rafaelromao/prisma/README.md

# Prisma

A wireless Choc v1 split keyboard: the handwired Diamond's 1333+2 layout on one
reversible PCB per half, a XIAO-sized nRF52840 module, and a 7 × 20 × 40 mm (500 mAh)
battery in each half. The halves join magnetically into a unibody, or stack back to
back for transport. The [project page](https://rafaelromao.github.io/prisma/) has the
boards, renders, BOM and build guide on one page.

## One board, either module

The board takes a Seeed XIAO nRF52840 (the genuine one) or a NologoTech Super52840
(also sold as "MINI NRF52840", "NRF52840 RE:1.4"). Both have the same 14 edge pins
on the same nRF52840 pins, so the firmware is the same; they differ underneath,
where the board reaches the battery, the 12th key and reset:

- **Battery.** Their battery pads are in the same two spots, but swapped: the XIAO's
  + (VBAT) is the pad nearer the module's middle, the Super52840's + (B+) the one
  nearer the USB end. A **battery selector** on the switch face picks which hole is
  +: bridge the row labelled `+MID` for a XIAO, `+USB` for a Super52840. Never both:
  that shorts the battery.
- **12th key (P0.09).** The XIAO's NFC1 pad, or the Super52840's P0.09 pad in its row
  of nine extra GPIO pads: a hole under each, on the same net. Under a XIAO, the
  Super52840's hole touches its NFC2 pad (P0.10), which is unused and idle.
- **Reset** is in the same place on both.
- The Super52840's USB-C legs come through its board: the PCB has clearance holes
  under them, and its USB-C sticks out 0.8 mm further, which the case's recess takes.

The Super52840's pads were measured from several photos, beside a ruler, against the
2.54 mm pin pitch. Its USB-C sits 0.3 to 0.6 mm off centre, towards the D0–D6 pins, so
the leg clearance holes, the notch in the board edge and the case's recess all allow
for that either way (its RST, GND and SWD pads land within 0.2 mm of the XIAO's). The
battery holes are small and sit inside both modules' pads, at least 0.25 mm from the
Super52840's GPIO row under the other half's module, wherever between the two photos'
readings that row really is.

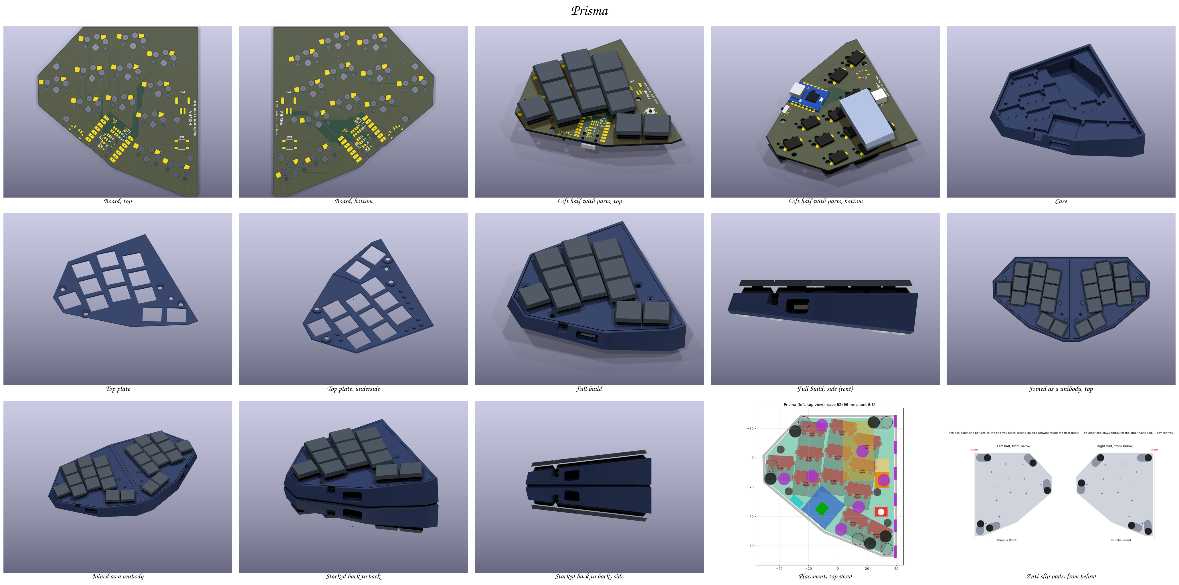
[picture p1: renders/all.png]
All views


| | |
|---|---|
| Keys | 24 (12 per half): 3×3, one pinky key, two thumbs, all 1u Choc |
| Key layout | The Diamond's angles and stagger (from `body_right.stl`), packed at Choc spacing (18 × 17 mm) |
| PCB | 87.6 × 92.3 mm, 2 layers, 1.6 mm, reversible: one design, order 5. Same cut-diamond outline, so two boards side by side form the diamond. A notch in the edge in front of the USB-C lets a cable's overmold reach the port |
| Wiring | Diodeless, one pin per key (11 Xiao pins + NFC1) |
| Case | Solid base, a pocket per part (0.6 mm clearance), 0.5 mm around the PCB and plate (0.3 at the seam), 93 × 100.5 mm per half at the girdle (the rim is 91.6 × 96.5), with a 45° chamfer under it; tent 6.6°; 20.4 mm at the seam, 10.5 mm at the outer edge (plate included, keycaps excluded). Five pad slots under the floor (below) |
| Anti-slip pads | 5 × 8×2 mm silicone bump-ons per half, as on the original Diamond's base: each slot under the floor (8.6 mm wide, 1.1 deep) holds two pad spots, 8.7 mm apart. Each half sticks its pad in a different end, so stacked, each pad drops into the other half's empty end and the floors (and magnets) still meet. Every key centre sits at least 2.8 mm inside each half's pads, so a press on a border key can't tip it |
| Top plate | Covers the whole board: 1.2 mm Choc v1 plate, 1.0 mm over the PCB (the flange sits 2.2 mm up), 14.0 mm cutouts (`cut_tol` 0.1 per side), a 0.5 mm pocket over the Xiao area for solder blobs, a pocket and cone over the reset button, support pillars, countersunk screw bosses, chamfered bottom edge |
| Power | XIAO nRF52840 or Super52840, 500 mAh 1S LiPo (nominal 7 × 20 × 40 mm) on a JST PH 2.0 socket, MSK-12C02 power switch next to the USB port on the lower outer facet. The wall has a recess the size of a USB-C overmold (14.6 × 7.4 mm, rounded corners, room for a module whose port sits off centre) in front of the port, and a slot open to the top for the lever, widening outwards for a fingernail, with a rounded floor |
| Reset | A 5.1 × 5.1 × 2.0 mm SMD tact switch (TS-1187A) on the switch face, in the nook between the index finger's bottom key and the thumbs, 7.6 mm from the nearest keycap. It reaches through a 45° cone in the plate (4.2 mm across at the top, 2.8 at the throat) with its plunger 0.2 mm under the plate's top: a fingertip presses it, keycaps and palms don't. Press once to reboot, twice for the bootloader, with the case closed |
| Screws | 4 × M3 × 8 flat head (90° countersunk) per half: through the plate and PCB, self-tapping into the solid Nylon base (2.5 mm pilot). `SCREW` in `design.py` switches to heat-set inserts |
| Magnets | One part everywhere: 8 × 1.5 mm N52 discs. Each half has 13: 4 original stacking positions, 3 stand contacts on a circle around the estimated centre of gravity, and 6 evenly spread across the inner wall at 17.8 mm pitch. Every pocket keeps 0.5 mm of plastic all round |
| Assembly | Iron only: no reflow-only parts |

The 500 mAh bay moves the battery away from the inner seam and raises the PCB **1.8 mm**,
keeping the existing 6.6° tent, PCB outline, connector and screw-hole positions. The nominal
7 × 20 × 40 mm finished pack is checked with a 7.5 × 20.5 × 41 mm envelope and the case's
clearance. Measure the actual protected pack, including tabs and wire exit, before printing;
never compress a pouch cell to make it fit. The electrical board and pin map are unchanged.
The trackball and trackpad use smaller 752025, 250 mAh batteries.

Use the half cases, dock and module parts from the same version together: their front facets and
heights are matched.

## Independent tenting on the Ugreen's tilting platform

Each half has three extra floor magnets on a **44 mm circle**, spaced **120° apart** around
the estimated assembled centre of gravity. The pattern is derived from a mass-weighted model
of the nylon case, PCB, battery, switches and magnets, checked by `stand_mount.py`; it is not
a measured balance point. Use two **steel tilting phone platforms**, not the stands' bases.
The owner has tested the platforms and confirmed that they attract magnets. The existing
case magnets attach directly: **no extra platform magnets or glue are required**.
All ten possible foot positions lie outside the centred 54 mm circular contact patch,
with at least **11.55 mm planar edge clearance**. They do not create an air gap there.
Keep the case magnets flush and adhesive off their faces. A larger or noncircular platform
must be checked against the feet, rubber coverings, lips and other obstructions separately.
The estimated gravity projection remains inside the three-contact triangle through 35° of tilt;
this does not certify the magnets' holding force or the stand's own stability.

`python3 stand_mount.py` checks the group and writes 1:1 alignment templates (not glue guides):
[left](case/stand_magnet_template_left.svg), [right](case/stand_magnet_template_right.svg).
Print at 100%: the dashed contact boundary is **54 mm** across; the magnet-centre circle is 44 mm.
That is the required clear flat
patch, **not a confirmed Ugreen measurement**. The 54 mm circle leaves only 1 mm from an
8 mm magnet's edge to the platform edge; prefer about **60 mm** where the real platform
still clears all feet. Measure its shape and surface before use. Steel attraction is confirmed,
but slip/peel resistance, typing loads and stability at the chosen tilt still need a physical
load test. Aluminium and nonmagnetic stainless steel are unsuitable; some stainless grades
are magnetic, so test the actual platform. The render uses an illustrative stand/platform.

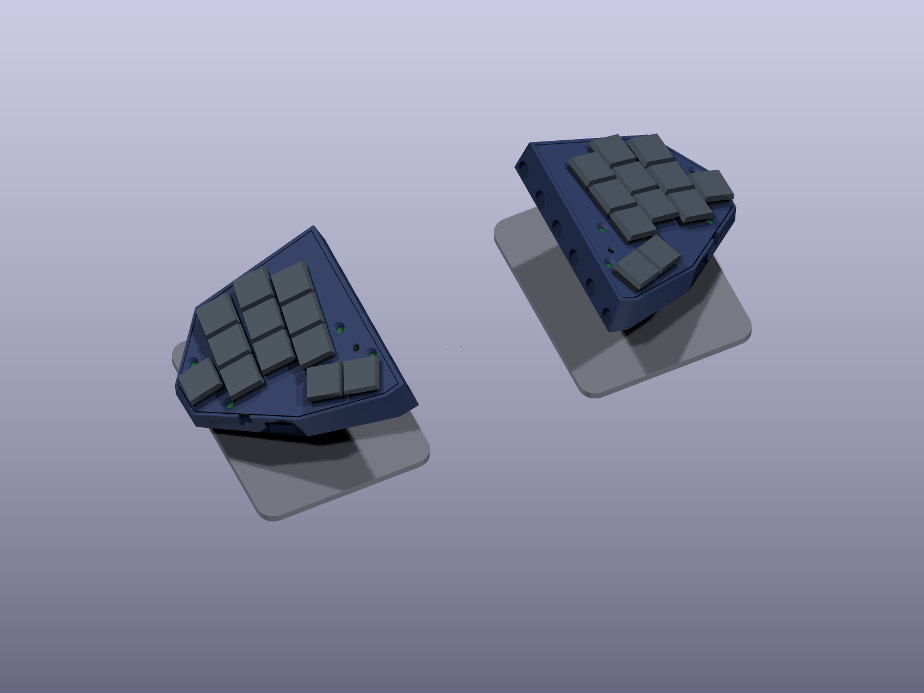
[picture p2: renders/independent_tenting.png]
Each half on its own tilting stand


## Before ordering

The board is made in one batch, so check what software can't:

1. **Print** `fab/print_1to1_F_face.pdf` and `fab/print_1to1_B_face.pdf` at 100 % ("Actual
   size", no fit to page). The board outline must measure 87.55 mm across.
2. **Lay the real parts on the prints**, each on the face it's soldered to. The module's
   castellations go over the edge pads, with its USB-C at the board edge. A Choc switch's pins and
   pegs go over one key's holes, and its hot-swap socket over the socket pads on the other face.
   Then the JST socket, the MSK-12C02 (its two pegs in the small holes) and the reset button.
3. **Super52840:** on the print, its B+ and B- pads must cover the two holes in the battery box,
   its `009` pad the round hole in the P0.09 box, and its USB-C legs land inside the two pairs of
   slots. Measure its height from its underside to the top of its USB-C shell: the case allows
   4.3 mm (the XIAO's).
4. **Firmware:** rebuild it before flashing (`b prisma -c` in rafaelromao/keyboards, branch
   `prisma`). `check_pcb.py` confirms that branch lists the board's pins, given the shield's
   `prisma_peripheral_left.overlay` and `_right.overlay` copied to `.render/fw_left.overlay`
   and `.render/fw_right.overlay`.

Checked by the scripts: JLCPCB's limits in the DRC (`pcb/prisma.kicad_dru`: annular ring
 0.18, pad holes 0.45 apart, tracks and clearance 0.10, silkscreen 1.0 mm text with a 0.15 stroke),
no tracks under the module's antenna, every net against its intent and the firmware's pin lists
(`check_pcb.py`), both modules' underside pads against the board's copper, and every part, plug,
screw, magnet and pad against the case (`check_fit.py`).

**Fabrication gate:** the battery holes have a 0.6 mm drill in a 0.96 mm pad: a **0.18 mm
annular ring**, the configured absolute minimum, not the 0.25 mm recommendation. The small
ring preserves the underside-pad and routing clearances; do not enlarge it without rerouting
and rechecking both module options. Obtain the fabricator's explicit acceptance of these
holes before ordering. A clean DRC does not establish production yield.

## Files

| Path | What |
|---|---|
| `fab/prisma_jlcpcb.zip` | Gerbers + drill files: upload to JLCPCB as they are |
| `fab/print_1to1_F_face.pdf`, `fab/print_1to1_B_face.pdf` | Both faces at full size, to lay the real parts on before ordering |
| `pcb/` | The KiCad 9 project, its footprint library, 3D stand-ins, and DRC rules |
| `case/case_left.stl`, `case/case_right.stl` | The printed base |
| `case/plate_left.stl`, `case/plate_right.stl` | The printed top plate, oriented top face down for printing |
| `case/dock.stl`, `case/insert.stl` | The cyberdeck dock, and the placeholder for its drawer (below) |
| `stls/` | The same printable parts under print-friendly names: case and plate left/right, dock, drawer insert, module tray, and the trackball/trackpad lids |
| `stand_mount.py`, `case/stand_magnet_template_*.svg` | Independent-stand contact check and 1:1 platform-magnet templates |
| `trackball/`, `trackpad/` | The drawer modules: scripts, `case/` STLs; the trackball's board in `pcb/` and `fab/` |
| `zmk/` | The modules' ZMK shields |
| `renders/` | Board, board with parts, case, full build; `all.png` has every view on one sheet |
| `BOM.md` | Parts list (AliExpress search terms) |
| `BUILD.md` | Hand-soldering and assembly guide, testing, printing |
| `index.html` | The project on one page: both boards, the renders, the BOM and the build guide (also served as the GitHub Pages home) |
| `design.png` | Top view of the placement: sockets (red), Xiao, battery, JST, magnets, screws, the reset button (red, its cone white), pad slots (grey: left pads filled, the right half's dashed) |
| `renders/pads.png` | Both floors from below: where each half's pads go |
| `*.py`, `*.sh` | The generators: everything above is built from them |

## Renders

| Board, top | Board, bottom |
|---|---|
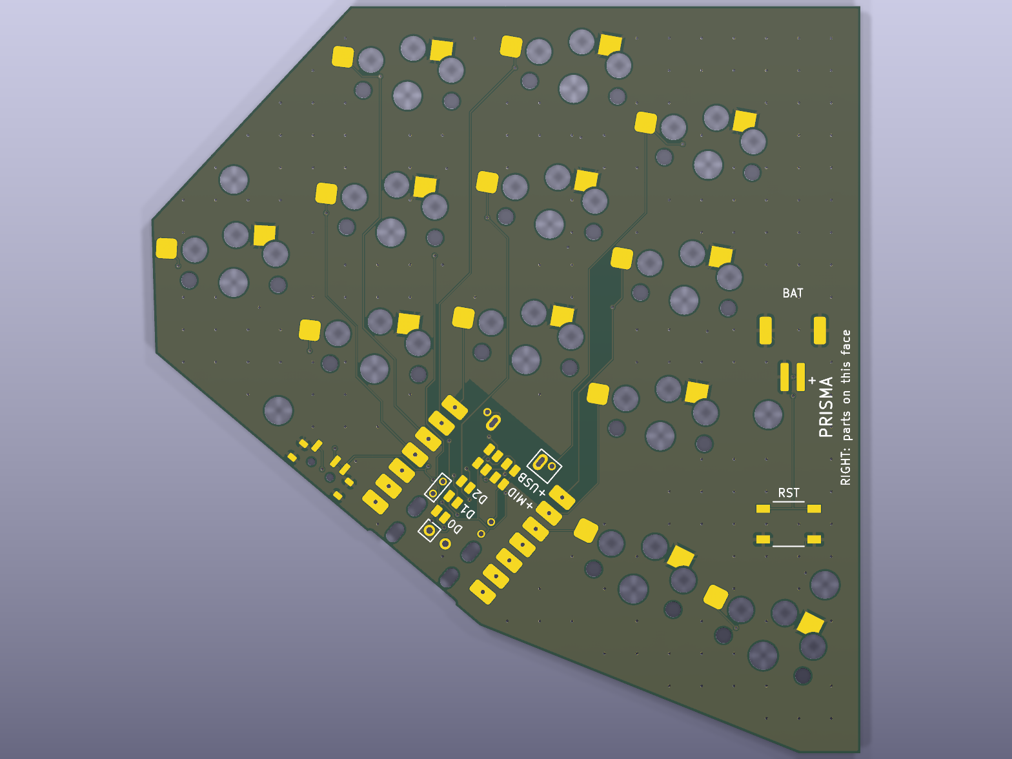
[picture p3: renders/board_top.png]
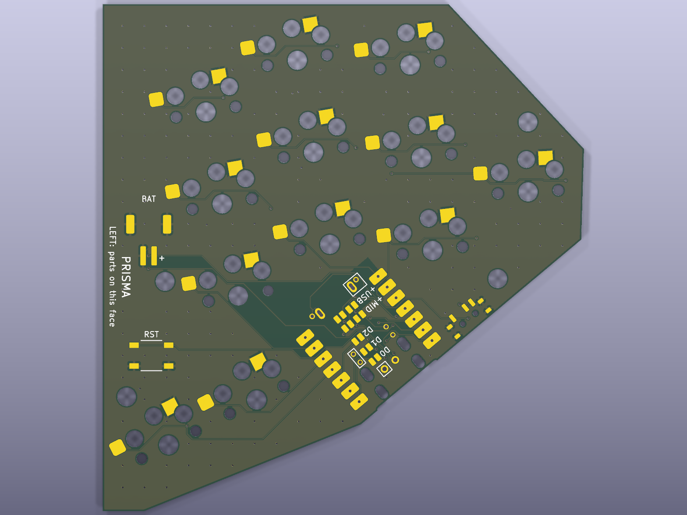
[picture p4: renders/board_bottom.png]
|  |  |
| **Left half with parts, top** | **Left half with parts, bottom** |
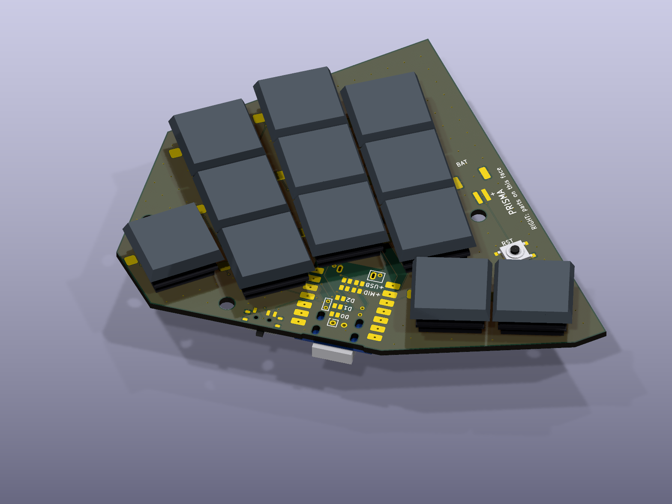
[picture p5: renders/parts_top.png]
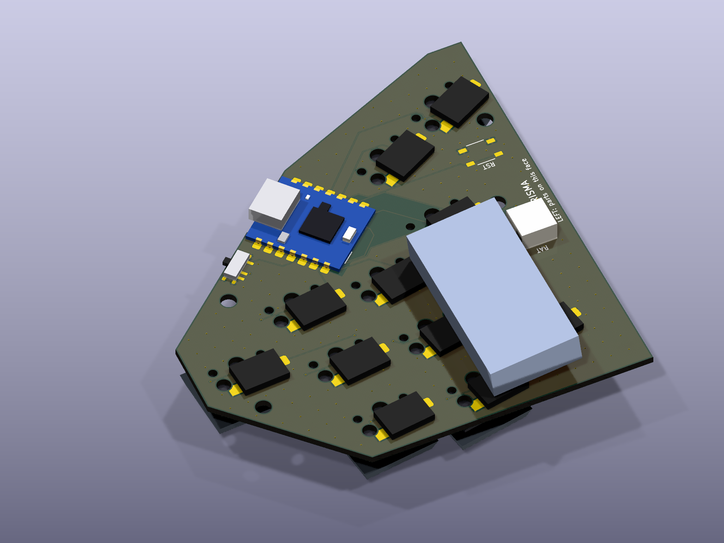
[picture p6: renders/parts_bottom.png]
|  |  |
| **Case** | **Full build, side (the tent)** |
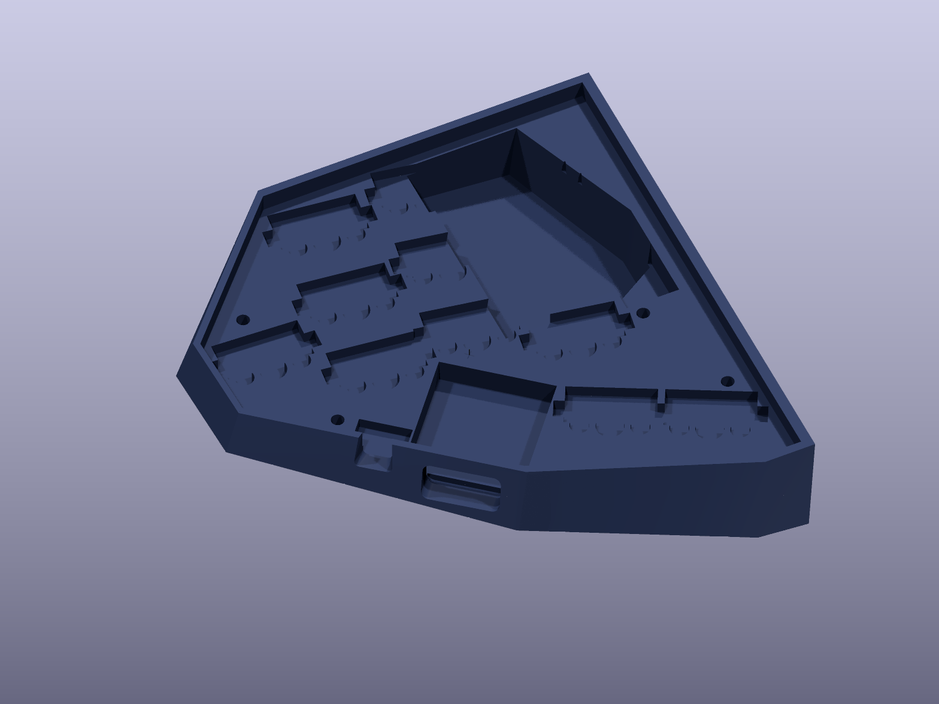
[picture p7: renders/case.png]
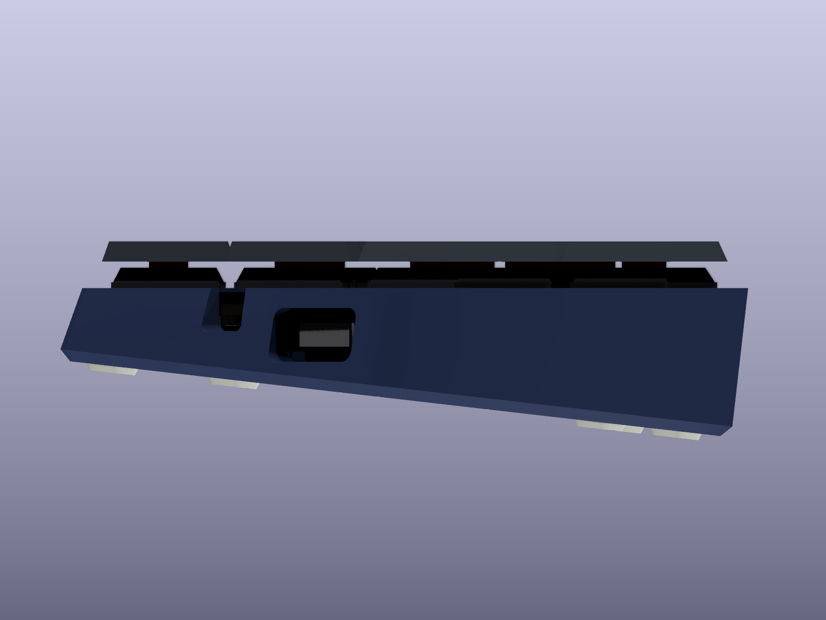
[picture p8: renders/full_side.png]
|  |  |
| **Top plate** | **Top plate, underside** |
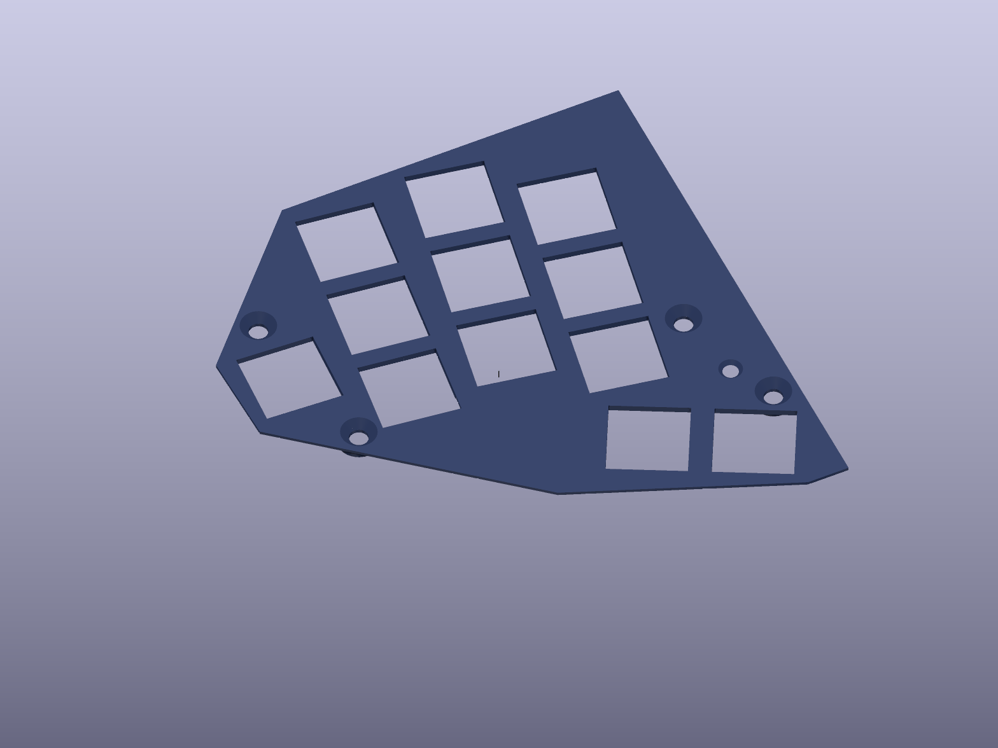
[picture p9: renders/plate.png]
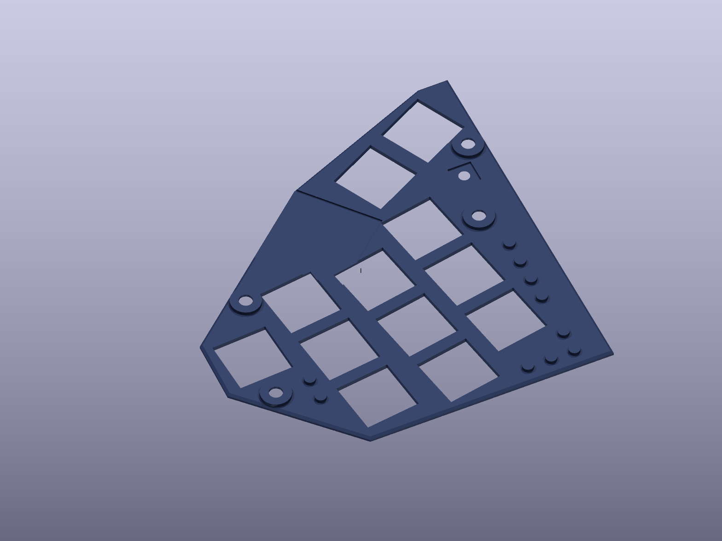
[picture p10: renders/plate_under.png]
|  |  |
| **Joined as a unibody** | **Joined, from above** |
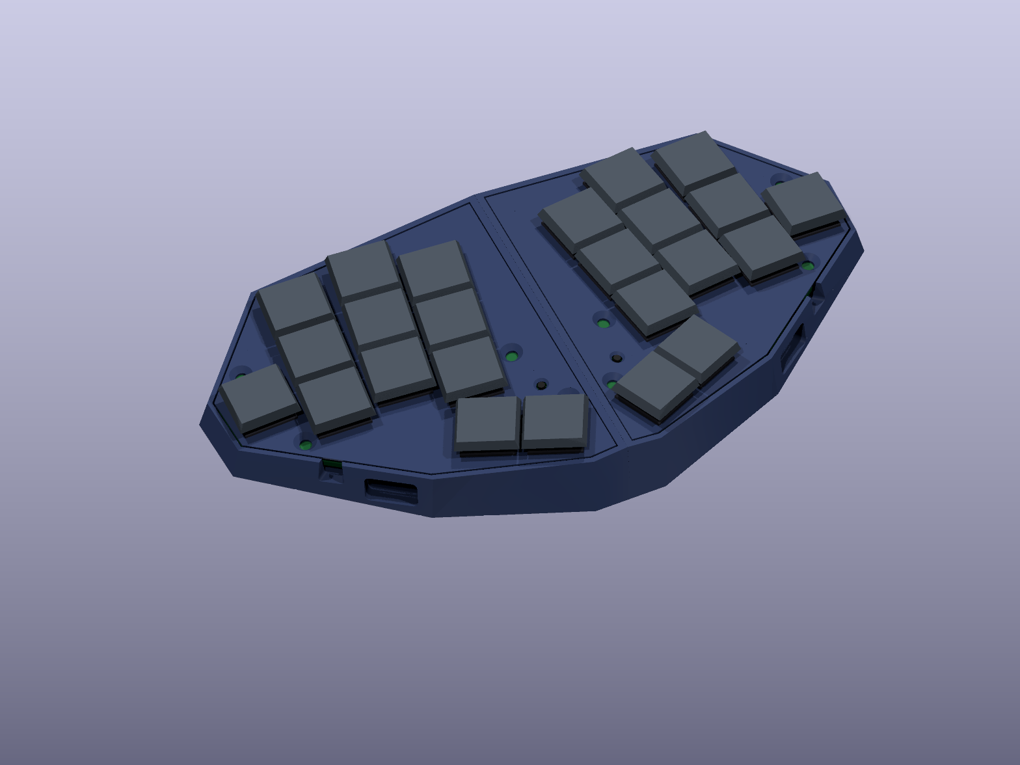
[picture p11: renders/unibody.png]
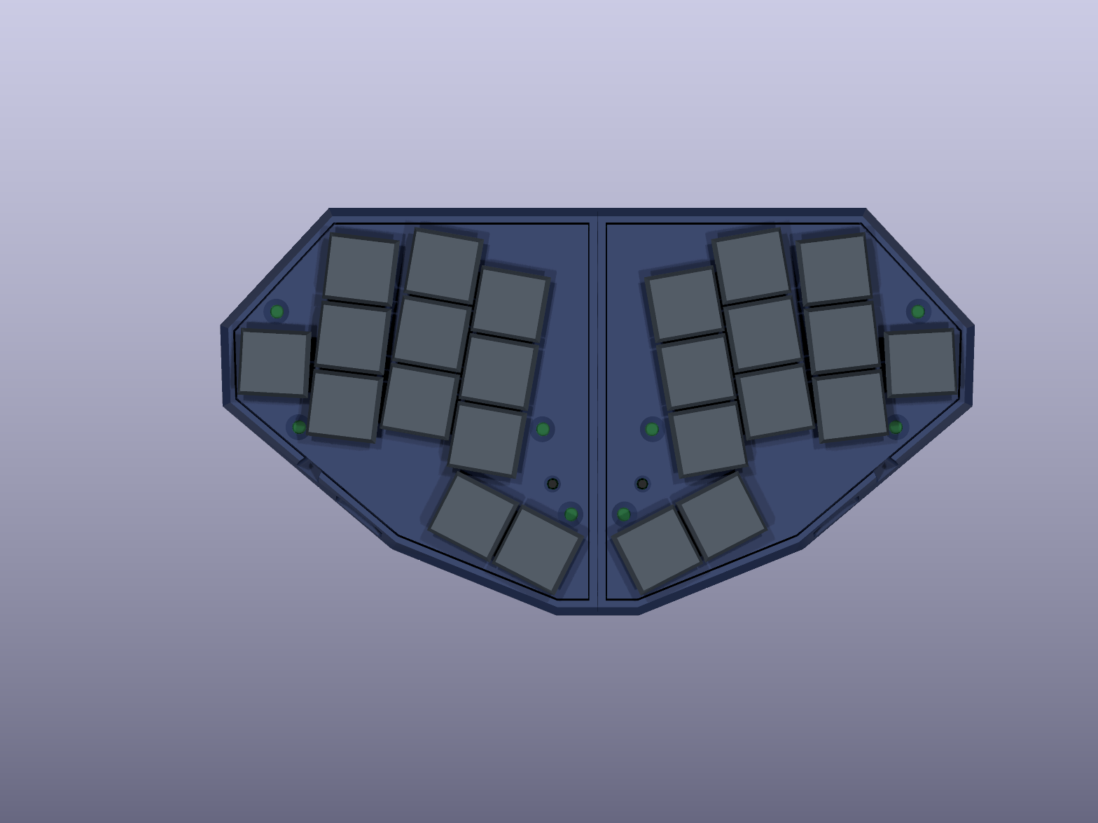
[picture p12: renders/unibody_top.png]
|  |  |
| **Stacked back to back** | **Stacked, side** |
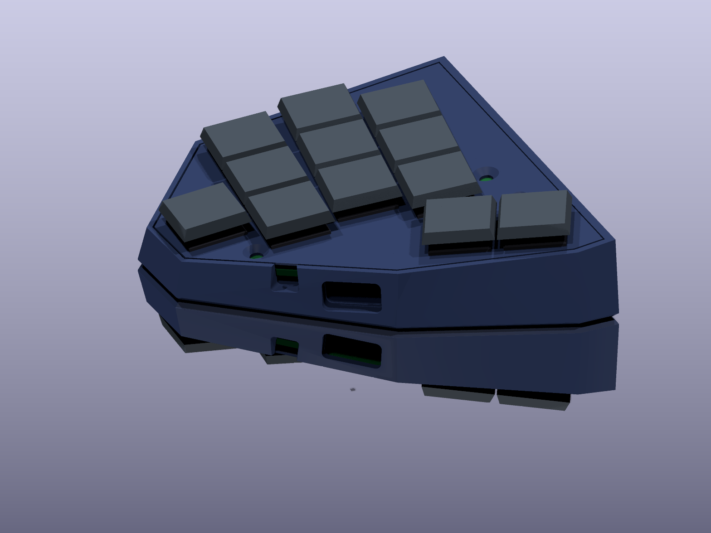
[picture p13: renders/stacked.png]
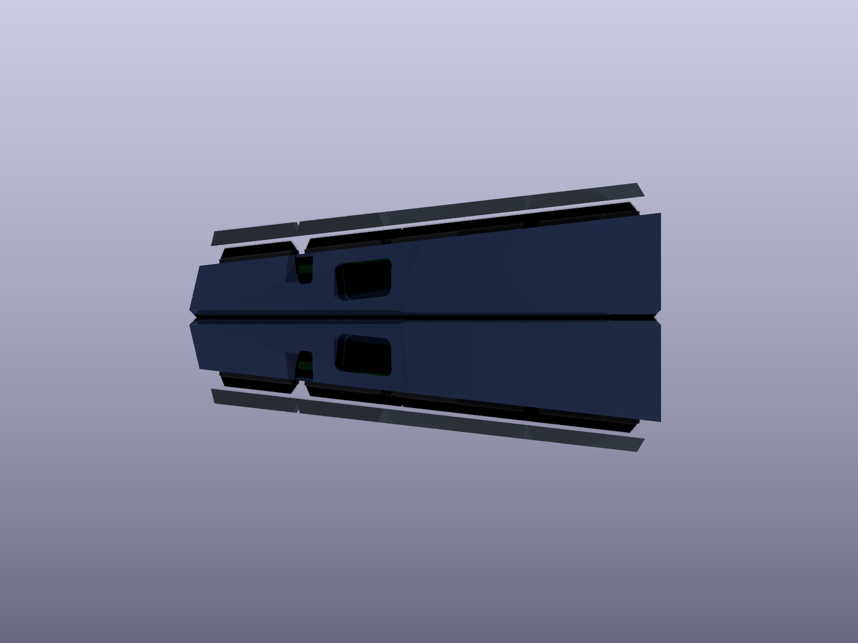
[picture p14: renders/stacked_side.png]
|  |  |

## Cyberdeck dock

A phone on a Ugreen folding stand (base 85 × 105 × 4 mm) is the computer and the screen;
`dock.py` makes one printed part, `case/dock.stl`, that holds both halves around it. Without the
stand it is a tented, splayed unibody, sturdier than the magnets at the seam alone.

- **Over the stand's base**, in a pocket in its underside: the base keeps its own feet on the
  desk and carries the phone. Behind the spine the base is left bare, its hinge (`HINGE`,
  30 × 28 mm, estimated from photos: measure yours) 0.5 mm (`HINGE_CLR`) off the halves, the
  wings and the spine, as far forward as their back corners let it. The pocket's fit holds the
  dock on the base, together with three pairs of the common **8 × 1.5 mm magnets**: three pressed
  into the pocket's roof and three glued on the aluminium base. The tent also keeps room for
  both discs and their backing below the drawer floor.
- **The board's lower half:** under each half's girdle, its widest line, every wall of the dock
  carries on the case's own 45° bottom chamfer down to the desk, one flat plane with it, front,
  back and sides, wings and spine alike. Each wall is built as a plane through its girdle edge, so
  none can fold. Below the girdle the spine and the wings are one piece; above it the spine stops
  0.2 mm short of the seam walls. The wing ends just short of the outer pad, which stands on the
  desk, and each pad recess is shaped to its bump-on's dome so none breaks out of a wall.
- **The halves on wings** the shape of their floors, inner side up, outer pad on the desk, splayed
  12° (`SPLAY`). The extra tent is the least that keeps 1.6 mm of plastic over the base and room
  under the magnets: 5.70°, about 12.3° in all. Every pad slot has a recess, both ends.
- **A spine** between the halves, level with their seam walls' top edges, its front and back
  carrying on both halves' walls, its point cut to a flat as wide as the joined board's front
  flat (about 20 mm). Its middle is a **drawer** (`DRAWER`), pulled out through the front, for a module
  (below) or the **placeholder** (`insert.py`, `case/insert.stl`): a solid block with the modules'
  outline and magnets, flush with the halves, the joined board's diamond cut into its top, and
  **PRISMA** in 0.5 mm low relief behind it. The
  drawer is open at both the top and the front. Its sides are straight and uninterrupted: no
  raised ends at the mouth, no ribs or matching grooves. The insert's front is shaped in 3D by
  the halves' exact front facet planes, rather than set back to a vertical wall, so the assembled
  front reads as one element. To take one out, push the tip of its rear hood forwards through the
  rear passage, then pull it out of the front. Lifting is not necessary.
- **Six side magnets per half:** the dock's continuous walls are 2.4 mm thick at their
  thinnest and house six of the common **8 × 1.5 mm N52 magnets per side**, matching all six
  half seam magnets. The gap between the halves is widened by 1.25 mm to preserve insert space.
  Load them from outside, flush, and glue them in; a verified **0.6 mm inner skin** retains them
  inside. Each faces the keyboard half directly outside and the insert's own matching magnet
  through the inner wall at three of those positions. The insert still has only three side
  magnets per side, evenly spaced at y = -7.0, 28.6 and 64.2 mm (seam magnets 2, 4 and
  6, every other magnet in the six-position row). The same insert magnets meet either half directly on the desk.
  Check magnetic holding force with real magnets before relying on it to carry the assembly.
- **A magnet under each pointing module:** one more 8 × 1.5 mm N52 disc in the module's floor and its
  mate in the drawer floor, on the centreline at y = −48.3 mm. Only three underside stand contacts are used, so at least 1 mm of plastic remains between opposing pocket envelopes, even with each pocket 0.2 mm off.
  The rear stays free for USB-C and the power switch.
- **Lap use:** the rear hood recess and USB passage remove material from the dock spine, and an
  insert is not bonded to it. Test a printed dock under load before relying on it for lap use.
- **Magnets in the wings** under six of each half's seven floor magnets. `MAG_COST` rejects
  positions that would add more than 1° to the tent needed for the base pocket. `MAG_ROOF`
  keeps 1 mm under a pocket over the base. Pockets near a 45° wall are nudged inwards to retain
  their surrounding plastic without losing alignment with the case's magnet.
- **Feet:** the underside is cut 0.5 mm (`FOOT_LIFT`) off the desk, and three 8 × 2 mm bump-ons
  under each wing, spread to the largest triangle, make that up.
- 199.0 × 111.3 × 29.8 mm, about 83 cm³. `python3 dock.py` prints the fit check: each half, its pads, the
  base and the hinge against the dock, all 0 mm³, and the plastic round every magnet and foot.

| **With the phone** | **From the front** |
|---|---|
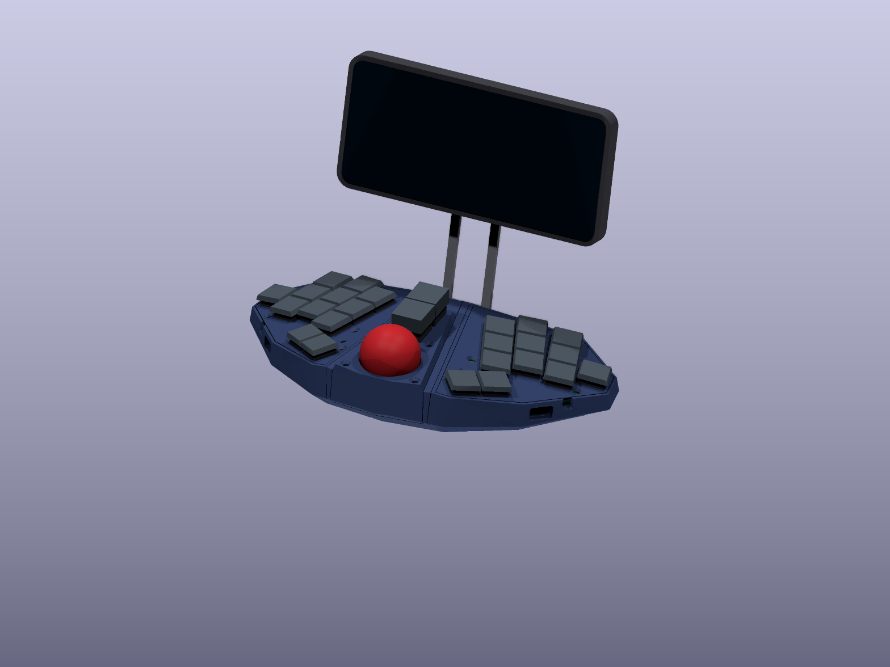
[picture p15: renders/cyberdeck.png]
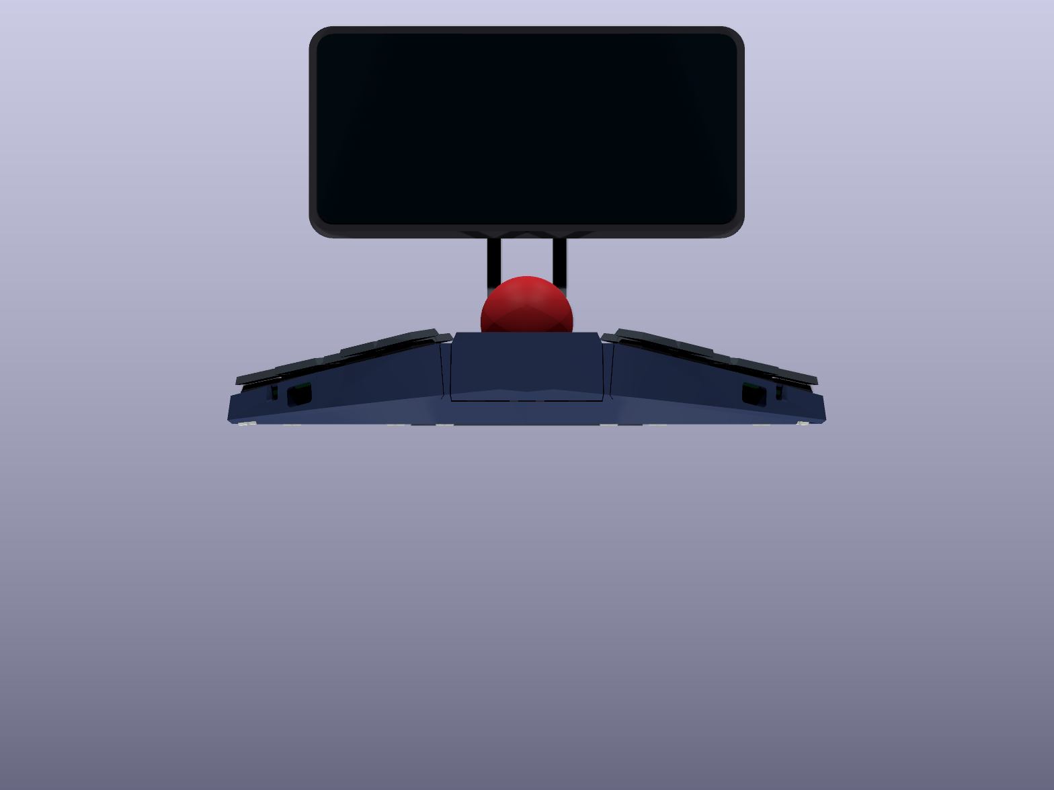
[picture p16: renders/cyberdeck_front.png]
|  |  |
| **Without the stand: a unibody** | **From the side** |
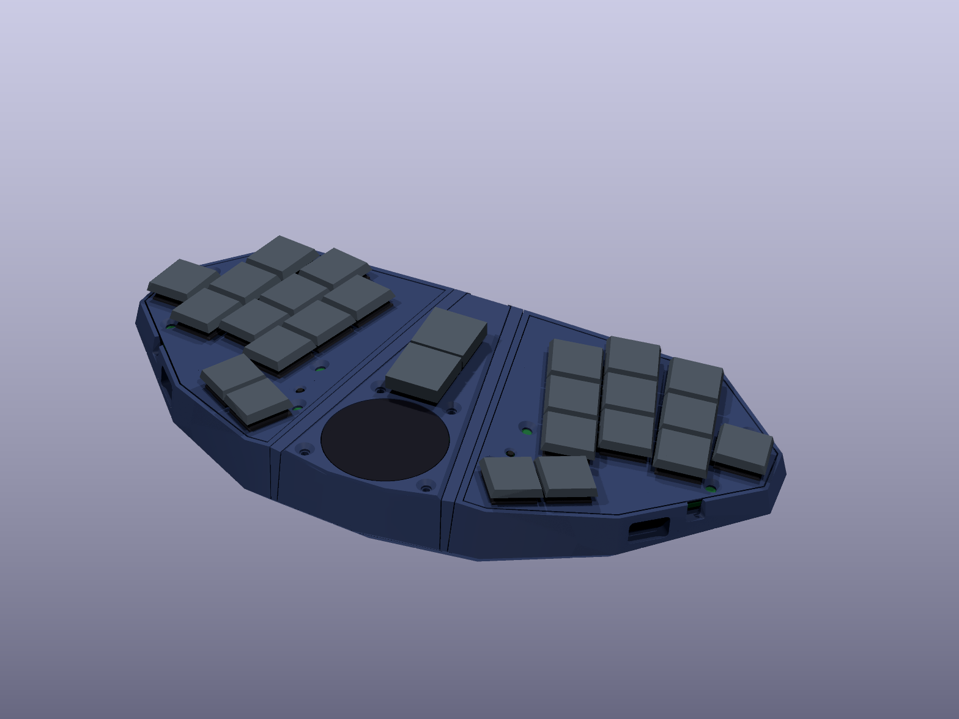
[picture p17: renders/dock_unibody.png]
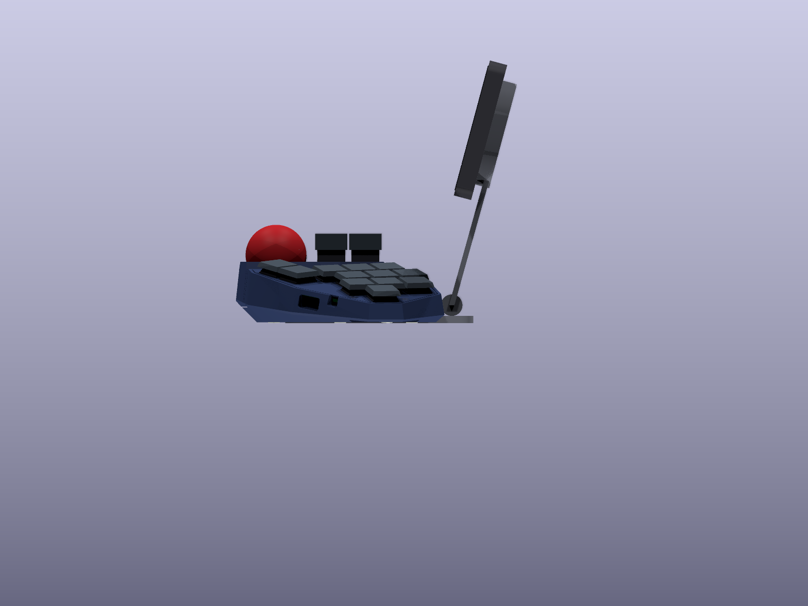
[picture p18: renders/cyberdeck_side.png]
|  |  |
| **The dock** | **Underneath** |
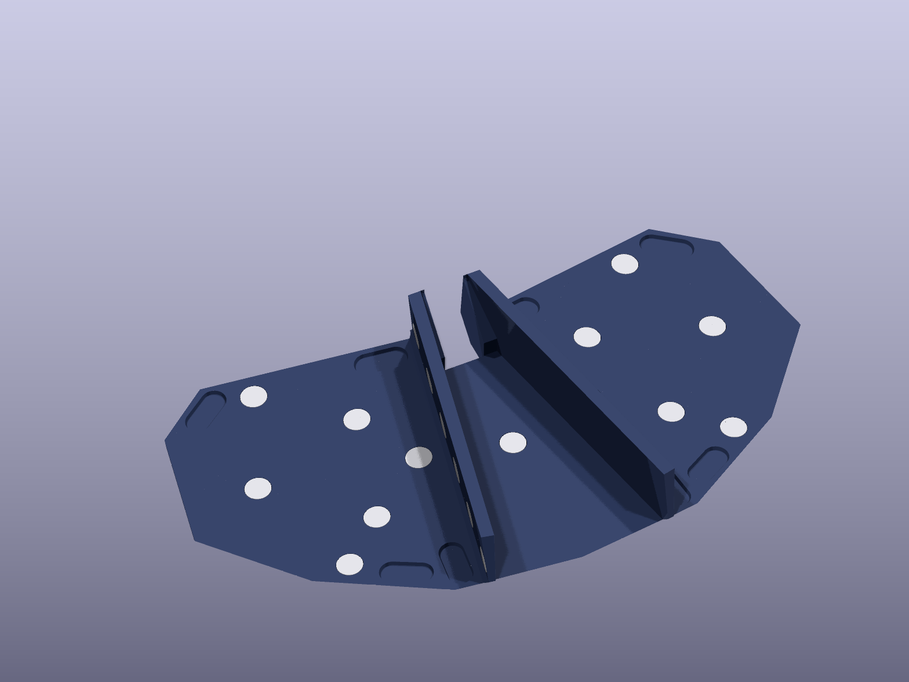
[picture p19: renders/dock.png]
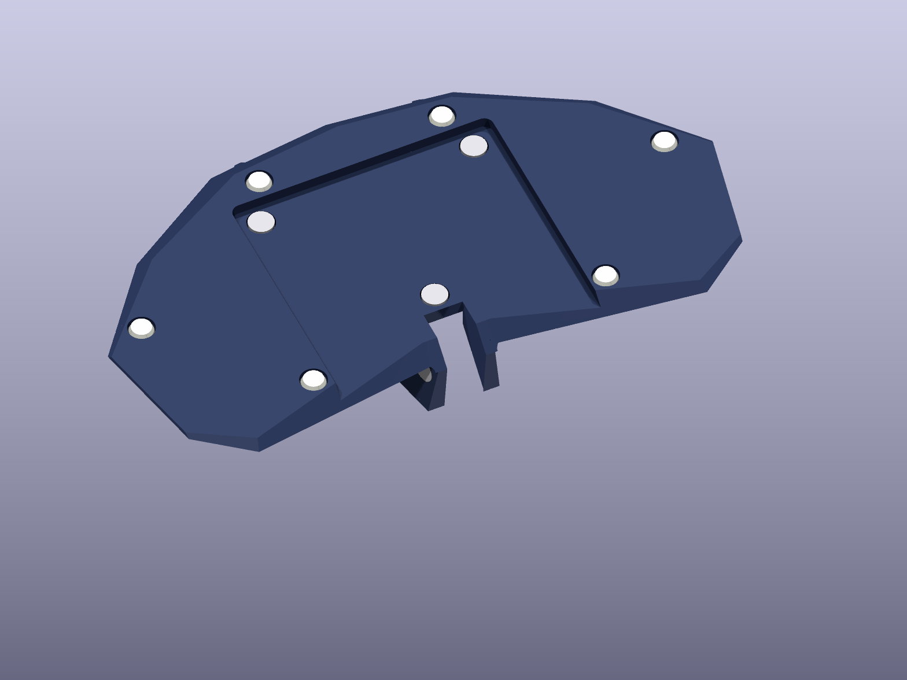
[picture p20: renders/dock_under.png]
|  |  |

## Drawer modules: a trackball or a trackpad

Two standalone ZMK pointing devices. Either slides into the dock's drawer from the front, or snaps onto
either half's inner wall on the desk, or sits on its own on its bump-ons. They are built like a half: a
tray, a lid, and the same M3 × 8 flat-head screws from the top. The tray is one print, shared by every
module; only the lid changes.

- **Shared by both:** the tray, the main board (keys, hot-swap sockets, power switch), a controller on its own small board,
  a 752025 (250 mAh) battery, and a sensor board holding the reset button. All in the same places, so the
  power slider, the USB-C port and the reset hole are in the same spot on every module.
- **Retention:** three common magnets a side where the halves' inner-wall magnets are (the 2nd, 4th and
  6th), at the same height over the plane both stand on, plus one in the floor over its mate in the drawer.

| **Trackball** | **The parts** |
|---|---|
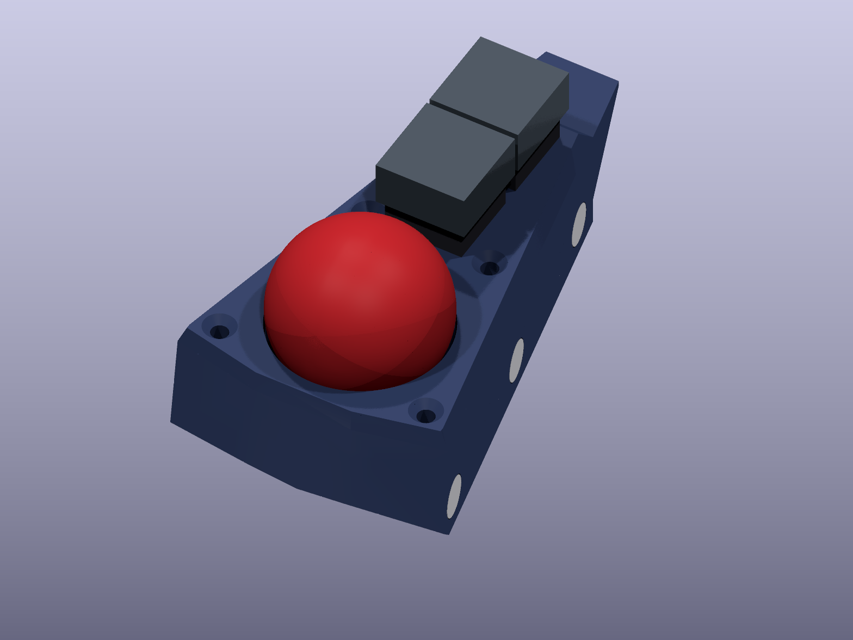
[picture p21: renders/trackball.png]
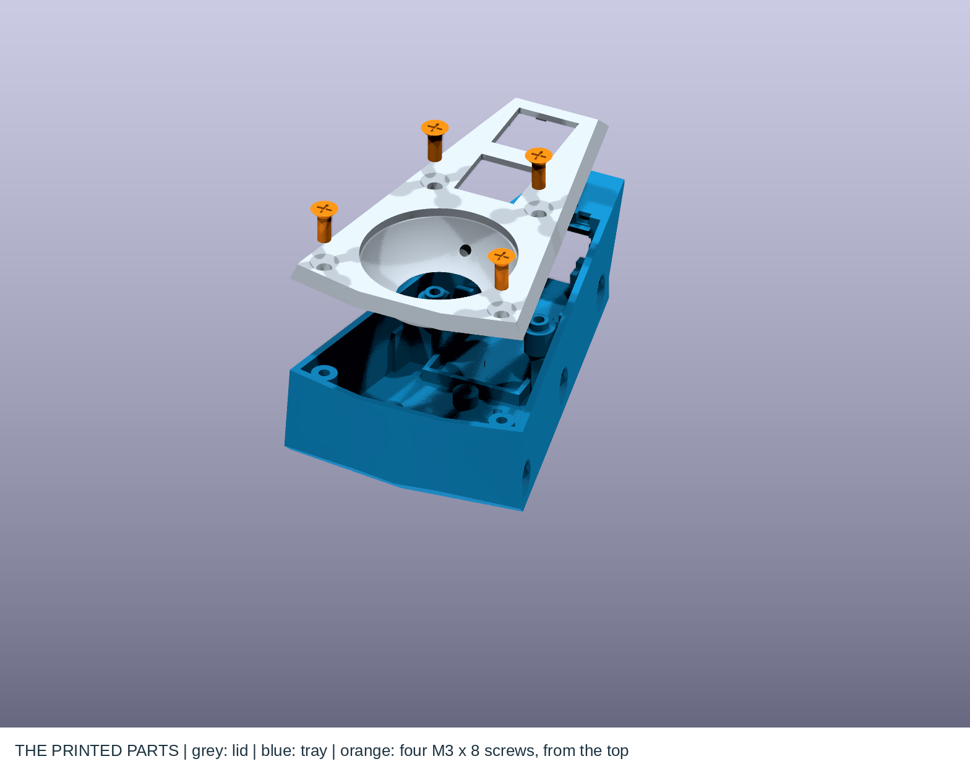
[picture p22: renders/trackball_structure.png]
|  |  |
| **Choc v1 lid, same tray and boards** | **Inside (cut through the middle)** |
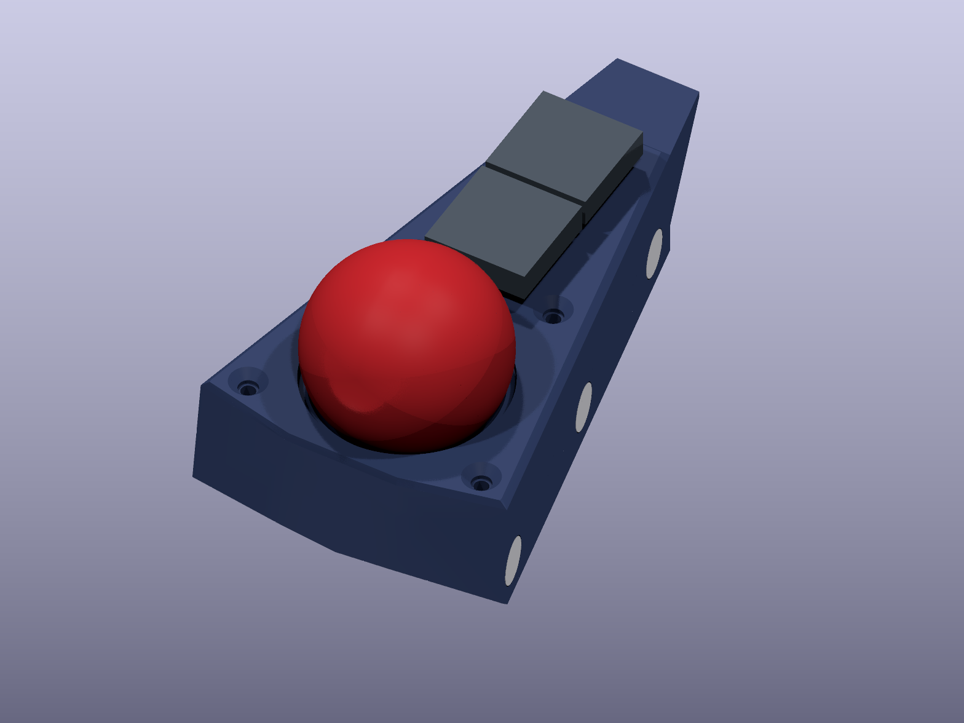
[picture p23: renders/trackball_choc.png]
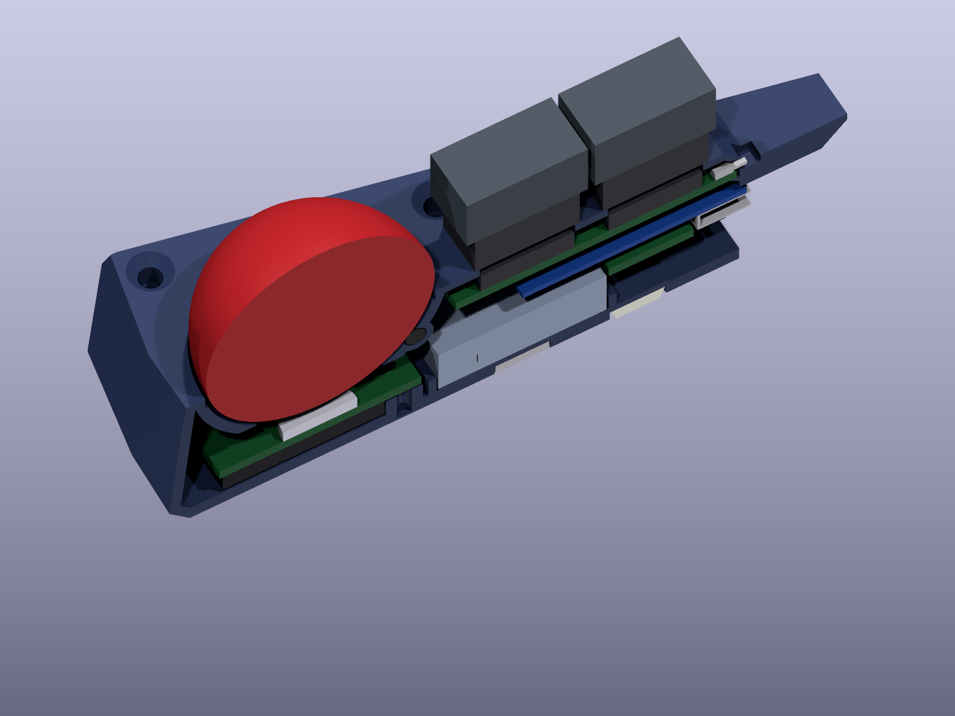
[picture p24: renders/trackball_open.png]
|  |  |
| **On a half, on the desk** | **Its boards (front / back)** |
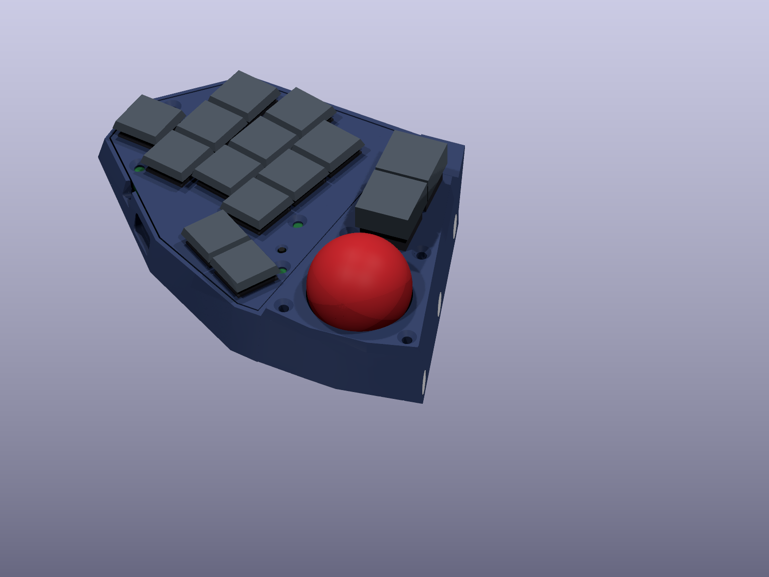
[picture p25: renders/trackball_with_half.png]
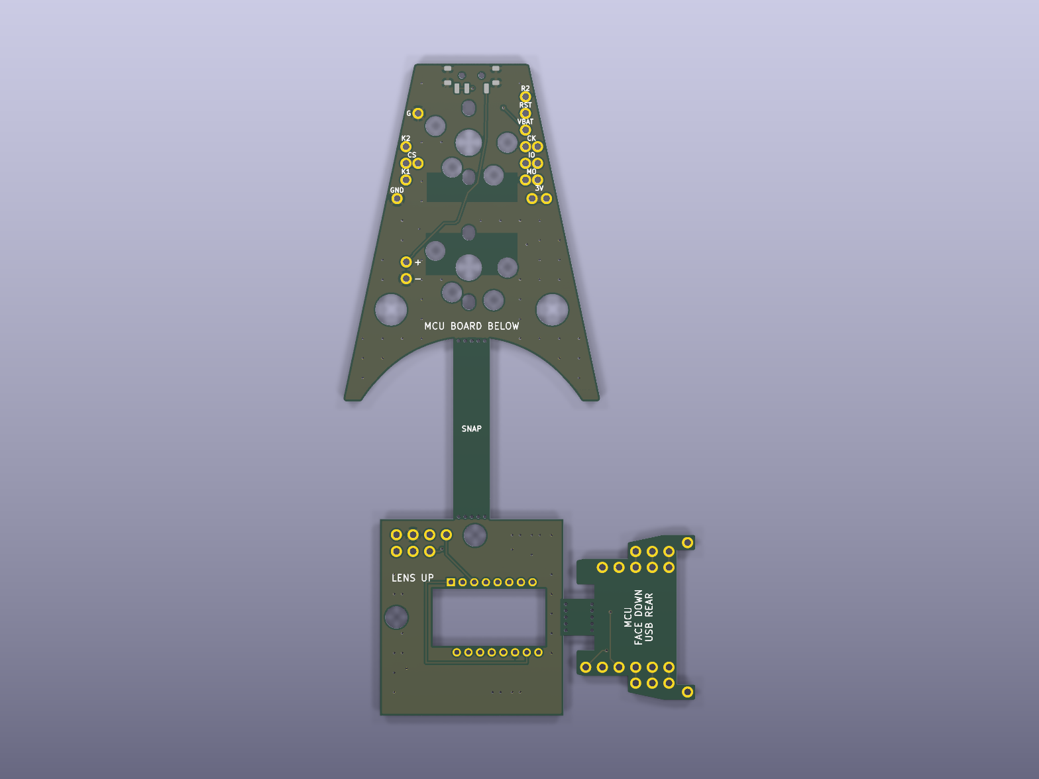
[picture p26: renders/trackball_board_top.png]
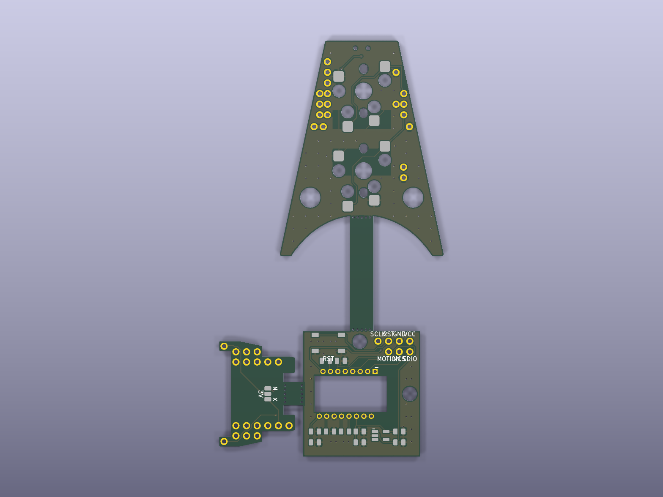
[picture p27: renders/trackball_board_bottom.png]
|  |   |
| **Trackpad** | **The parts** |
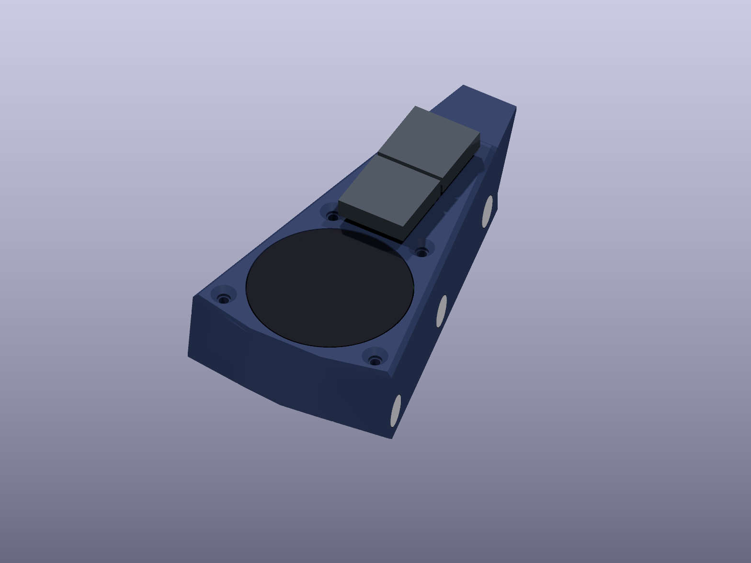
[picture p28: renders/trackpad.png]
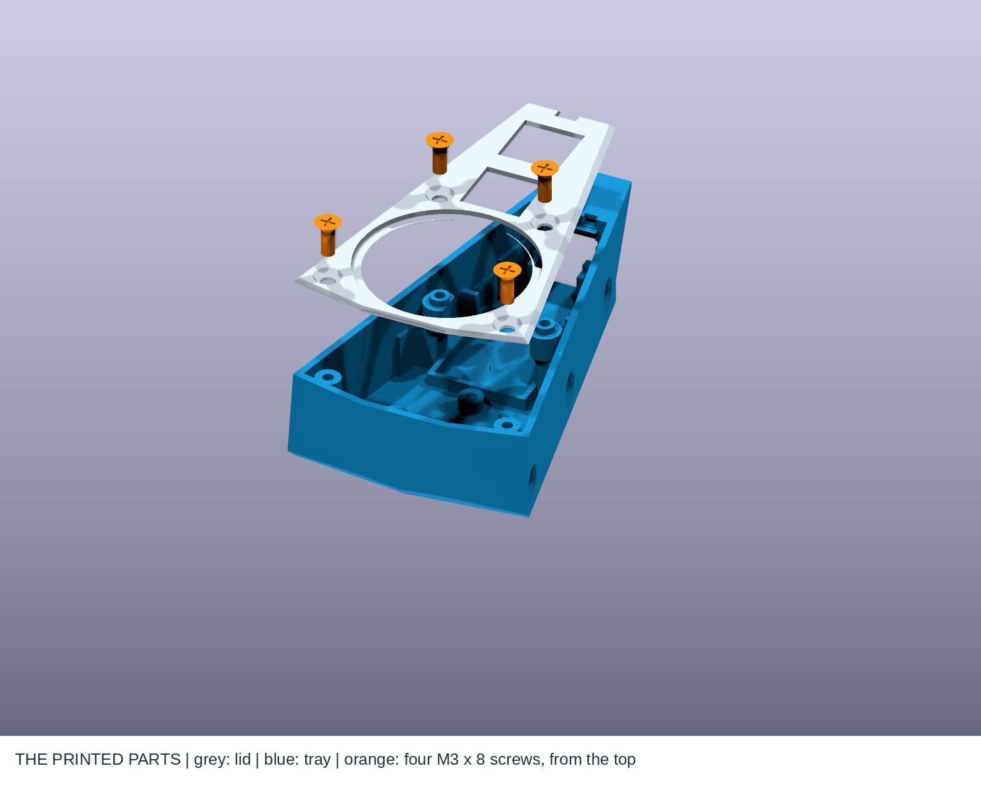
[picture p29: renders/trackpad_structure.png]
|  |  |
| **On a half, on the desk** | **The placeholder in the drawer** |
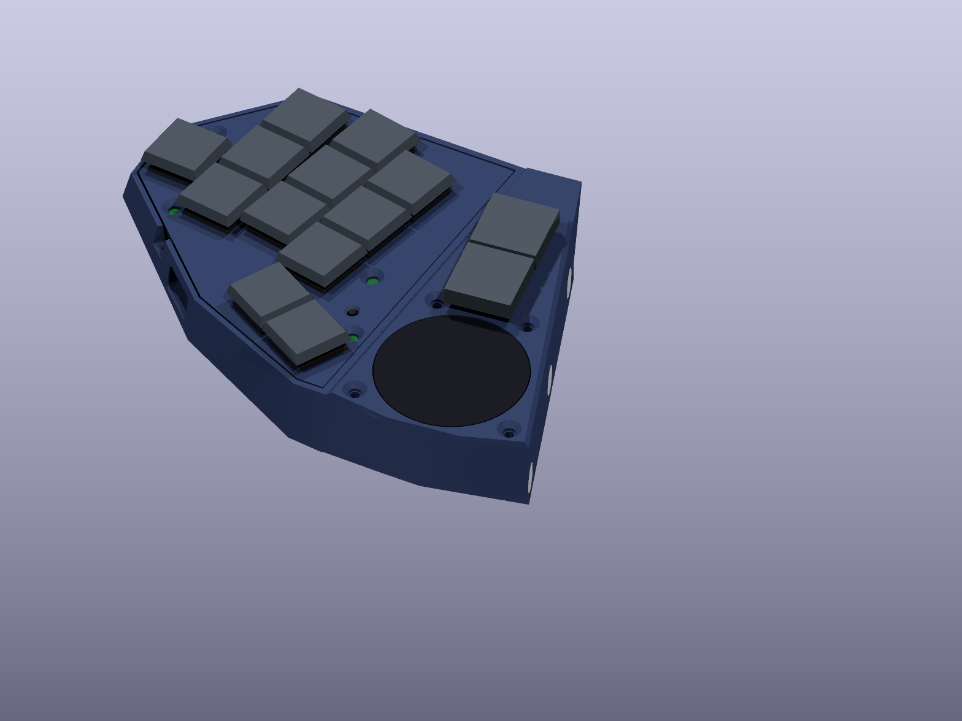
[picture p30: renders/trackpad_with_half.png]
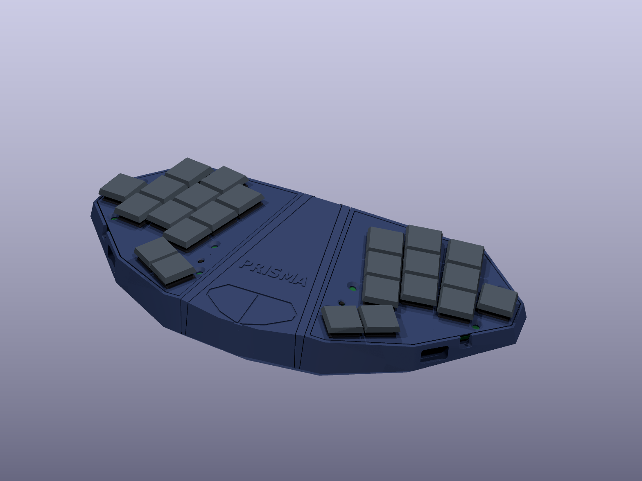
[picture p31: renders/dock_insert.png]
|  |  |

### USB-C

The USB-C port is flush with the module's back, under the power slider, with no wall or floor beneath it,
so a plug goes straight in. The dock has a **12.8 mm wide rear passage all the way down through the
underside**: the nominal model allows a 12.35 × 6.5 mm overmold; check the actual plug and print. At the rear the module's top
extends over the dock's sloped support: the common underside and its mating support are 45°, with 0.4 mm
clearance.

| Trackball: rear connection | Cutaway to the receptacle |
|---|---|
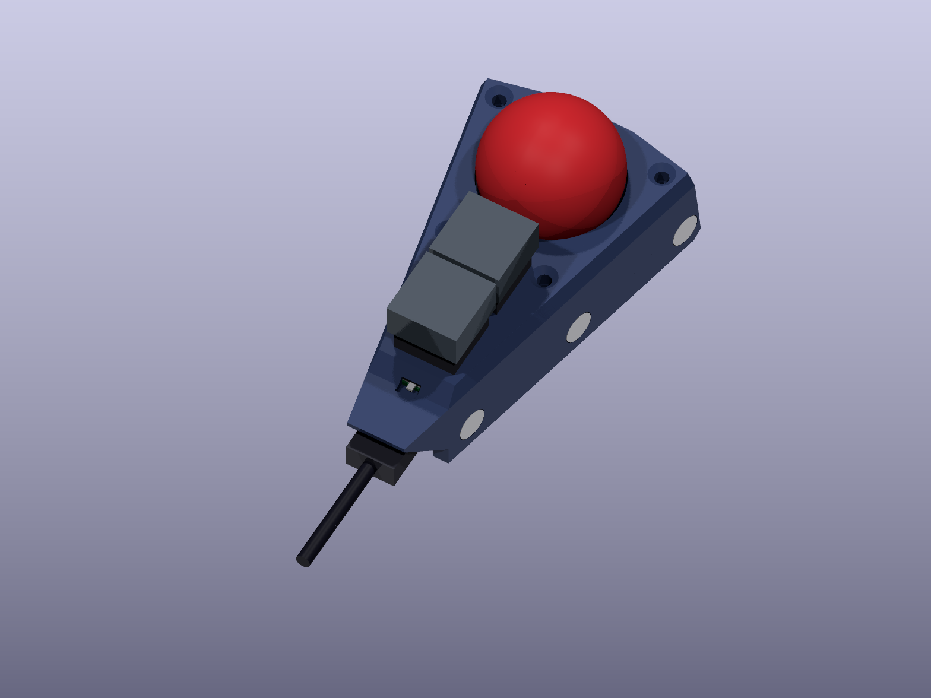
[picture p32: renders/trackball_usb.png]
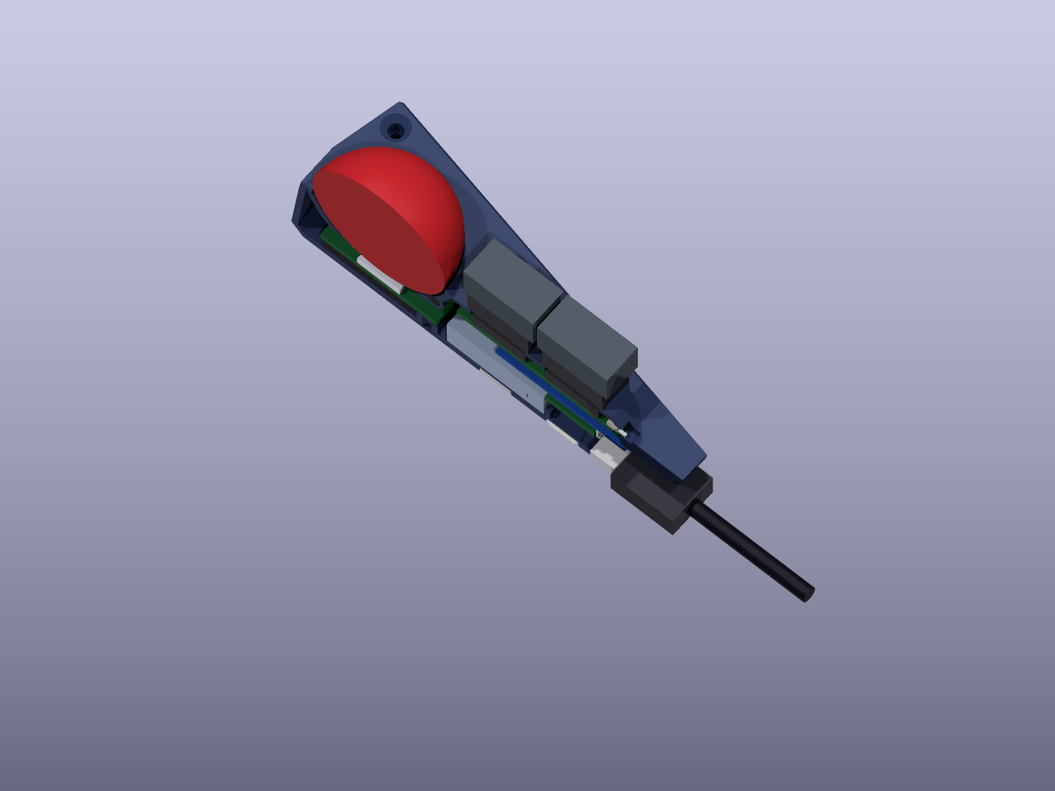
[picture p33: renders/trackball_usb_open.png]
|  |  |
| Trackpad: rear connection | Cutaway to the receptacle |
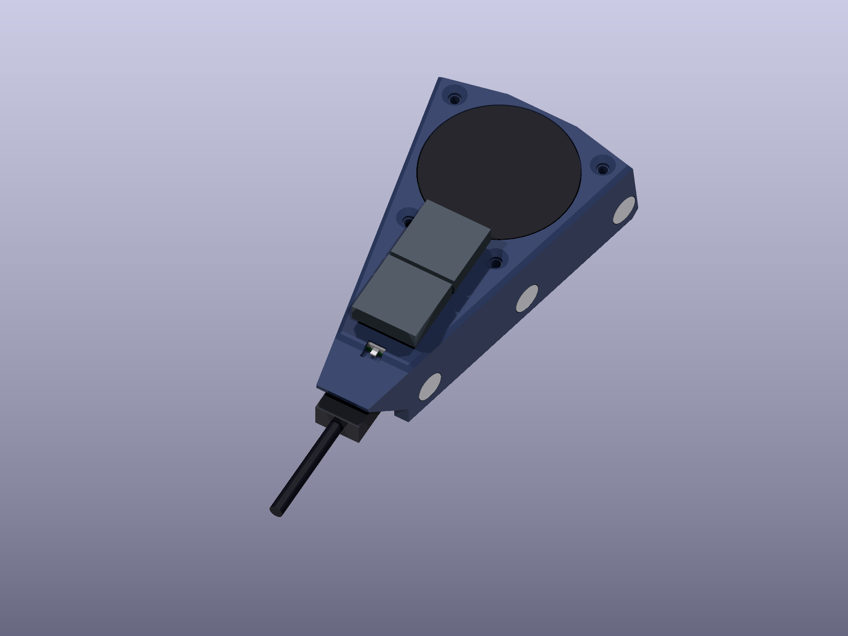
[picture p34: renders/trackpad_usb.png]
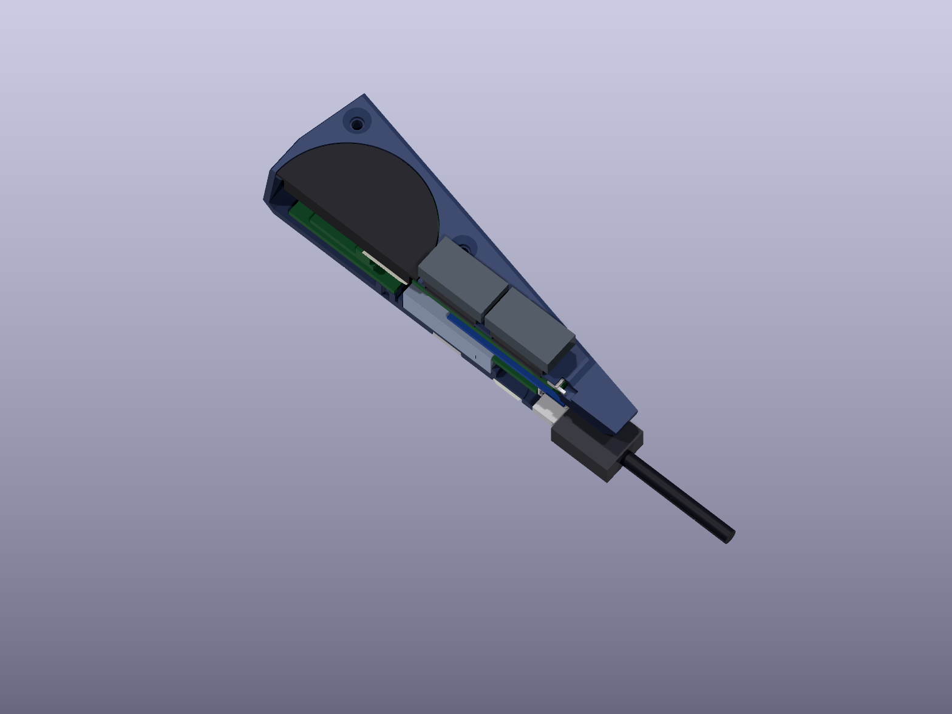
[picture p35: renders/trackpad_usb_open.png]
|  |  |
| Trackball docked | Trackpad docked |
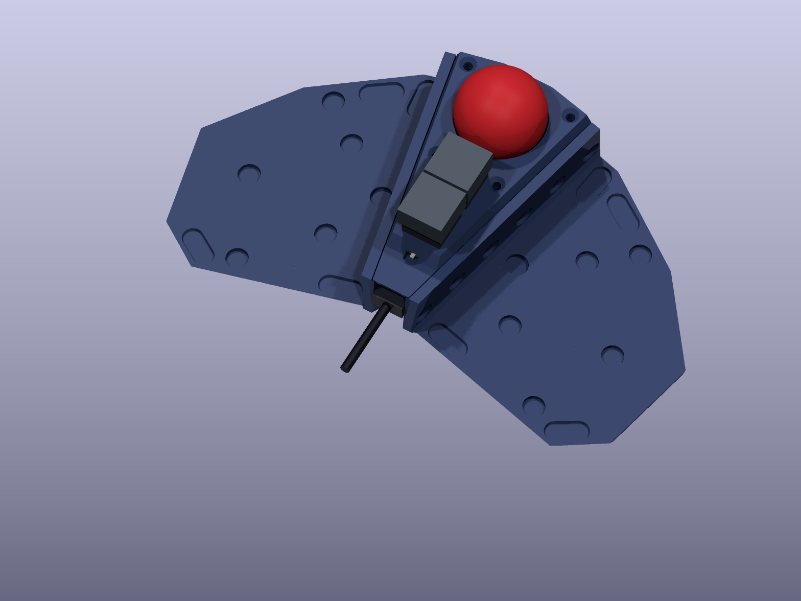
[picture p36: renders/trackball_usb_dock.png]
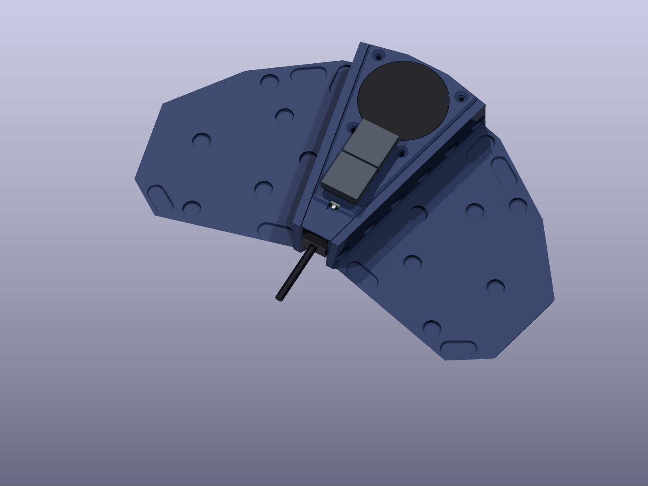
[picture p37: renders/trackpad_usb_dock.png]
|  |  |

### Prisma Trackball (`trackball/trackball.py`)

A 34 mm ball and two MX or Choc v1 hot-swap keys on one shared PCB. The MX lid stands 4 mm over the
halves; the Choc lid 1.2 mm. Their front and side upper facets run from the halves' top height to the lid top. The front facet is steeper to preserve the 40 mm trackpad rim and key/power-switch clearance; the lower front remains matched to the drawer.

- The ball sits in a cup in the lid on three 3 mm Si3N4 balls and lifts straight out. Under it, a PMW3610
  on its own board looks up through an LM18-LSI lens (circuit after siderakb's pmw3610-pcb, CERN-OHL-P-2.0,
  at 3.3 V logic with a TLV74318).
- The main board accepts **MX or Choc v1 hot-swap sockets**, not both populated together. Choc sockets
  face 180° opposite the MX sockets. MX uses `trackball/case/lid.stl` (1.5 mm plate), Choc uses
  `trackball/case/lid_choc.stl` (1.2 mm plate). Choc v2 is not supported.
- The controller stands face down on a standard 2.54 mm header on its own small board, its USB-C port
  flush with the back wall. That board drops into the tray between printed stops, which take a plug's force.
- Eight 15 mm stacking pins join the controller board to the main board, beside the controller, and the battery and reset
  come by wire from the controller's own pads to `VBAT` and `R2`. The main board does not lift out once they are soldered.
  The sensor's SCLK, SDIO (3-wire SPI), NCS and MOTION go to pads `CK`, `IO`, `CS` and `MO`. Each pad takes one
  controller pin, on both modules; the table is in `BUILD.md`, and in `trackball/controller_pinout.py`.
- One panel to order (`trackball/fab/trackball_jlcpcb.zip`), 53.7 × 99.5 mm: the main board and the
  sensor board at opposite ends of a long bridge, with a row of snap holes at each end, and the
  controller board on a short tab off the sensor board's side.
  `trackball/route.sh` builds, routes and checks it (`build_pcb.py`, Freerouting, DRC).
- **One orderable panel for nice!nano v2 or plain XIAO nRF52840:** both stand on the same header. Rows 5 to 7 are
  GPIOs on both, so the signals differ only in firmware. One solder jumper chooses the 3.3 V pin:
  a nice!nano has VCC in row 4 where a XIAO has 3V3 in row 3. Its pin rows sit 0.2 mm further back than a
  nice!nano's, so a XIAO's USB-C mouth lies 0.2 mm inside the rear plane. The tray's seats and stops clear the
  Seeed STEP reference, but actual revisions, clones, wiring and retention still need checking.
- The sensor's posts print 0.4 mm low. Equal shims can adjust the optical gap, but the real ball-to-board
  distance and lens reference-plane height must be measured; see `BUILD.md` for the calculation and limits.
  Finish the two sensor-board screws to **≤7.6 mm overall** and deburr them outside the assembly.
  Head seating in the straight PCB hole consumes 0.22 mm in the model; verify at least 0.3 mm
  tip clearance and adequate engagement at the actual shim thickness before installing the battery.
  The four lid screws remain M3 × 8, unmodified.

### Prisma Trackpad (`trackpad/trackpad.py`)

The same module with a 40 mm Cirque (TM040040, I²C) in the lid instead of the ball. It uses the Choc
sockets on the shared main board and stands at the Choc lid's height, 1.2 mm over the halves.

- Use compact **17.5 × 16.5 mm Choc caps**. Conventional twin-stem caps rotate with the
  switch, putting **17.5 mm front-to-back** here; they cannot be independently quarter-turned.
  The centred nominal pad-to-cap gap is **0.585 mm**; an 18 mm square envelope has only
  **0.335 mm**. The seat's 0.3 mm radial allowance can reduce these to **0.285/0.035 mm**
  before print error or wobble. Check actual pad placement, adhesive, cap travel and wobble;
  these are not first-print fit guarantees. The front screw centres are now
  x = ±21.0, y = −91.5 mm, leaving **2.087 mm** from the countersink envelope to the pad seat
  (formerly 0.871 mm). Use the new tray and lids together; PCB holes and key positions are unchanged.

- Retain the supplied I²C breakout with its pull-up resistors and original 12-pin flat cable.
  Four wires connect the MCU to the breakout; one separate DR wire connects the MCU directly to the
  Cirque underside. The sensor/reset board area reserves a 24 × 18 × 4.5 mm breakout envelope on a
  2.5 mm insulating spacer, plus cable-bend room, with no printed holder. Verify actual kit dimensions.

| Wire | nice!nano v2 | Plain XIAO nRF52840 |
|---|---|---|
| Breakout SDA, on pad `IO` | D3 (P0.20) | D5 (P0.05) |
| Breakout SCL, on pad `CK` | D2 (P0.17) | D4 (P0.04) |
| Cirque DR, separate underside wire, on pad `MO` | D4 (P0.22) | D6 (P1.11) |
| Breakout GND, VDD | GND, VCC (3.3 V) | GND, 3V3 |
| Main board K1, K2 | D19 (P0.02), D21 (P0.31) | D7 (P1.12), D9 (P1.14) |
| Main board `G`, by stacking pin | GND | GND |
| Main board `VBAT`, `R2`, by wire | B+, RST | BAT+, reset pad |

Use I²C at address `0x2A`; confirm R1 is absent on an SPI-labelled kit and leave R7/R8 fitted for
3.3 V operation.

**Firmware** (`zmk/`): a ZMK config with both shields, `prisma_trackball` (the PMW3610 through
badjeff's zmk-pmw3610-driver) and `prisma_trackpad` (the Cirque through Zephyr's in-tree
Pinnacle driver), pinned in `zmk/config/west.yml`. Key 1 clicks left; key 2 clicks right, and
held turns pointing into scrolling; both together click middle. If the pointer runs the wrong way,
check the selected driver's orientation settings against its binding before changing the overlay.

`python3 -m unittest test_stl_export test_half_battery test_drawer test_module_assembly test_xiao_option trackball.test_layout`
runs the checks.

For the XIAO shields, initialize a west workspace from `zmk/config/west.yml`, then build ZMK's `app`
for `xiao_ble//zmk` with `SHIELD=prisma_trackball_xiao` or `prisma_trackpad_xiao` and
`ZMK_EXTRA_MODULES` set to this directory's absolute `zmk/` path. For example, from that workspace:

```sh
west build -s zmk/app -d build-trackball -b xiao_ble//zmk -- -DSHIELD=prisma_trackball_xiao -DZMK_EXTRA_MODULES=/absolute/path/to/prisma/zmk
west build -s zmk/app -d build-trackpad -b xiao_ble//zmk -- -DSHIELD=prisma_trackpad_xiao -DZMK_EXTRA_MODULES=/absolute/path/to/prisma/zmk
```

The generated `zephyr/zmk.uf2` is controller-specific. Compilation is not a physical sensor, charging or Bluetooth test.

## How a reversible board makes two halves

The left half gets its parts on the bottom (B) face. The right half is the same
board turned over, so its parts go on the F face. Silkscreen says which face is
which (`LEFT: parts on this face`).

Turned over, the Xiao's pins land mirrored: where the left half has D0, D1 and D2,
the right half has VBUS, GND and 3V3. Those three pins reach their keys through
solder jumpers. **Bridge the three jumpers on the face without the Xiao** (inside its
outline, labelled D0–D2) and leave the other three open. The other eight edge pins
are GPIO either way. The firmware just lists different pins per half.

Diodeless needs 12 inputs and the Xiao's edge only has 11, so the 12th key uses
the NFC1 pad on the Xiao's underside, through a plated hole you solder from the
other face. NFC itself is not used.

The reset button is wired the same way: the Xiao's reset test pad (pad 17 in
Seeed's footprint, `EN` in their symbol; TP2 on the nRF52840's P0.18/RESET in
Seeed's schematic) is reached through a plated hole filled from the switch face,
and the button joins it to GND. Each half's reset hole has its own net (`RST_L`,
`RST_R`) wired only to that half's button pads: turned over, one half's reset
hole lands under the other half's GND test pad. No pin changes, so the firmware
is unaffected.

Pin map (from `pcb/pinout.json`):

| Key | Left | Right |
|---|---|---|
| pinky | D0 | D0 |
| ring top / home / bottom | D4 / D3 / D1 | D9 / D10 / D1 |
| middle top / home / bottom | D5 / D2 / D6 | D8 / D2 / D7 |
| index top / home / bottom | NFC1 / D7 / D8 | NFC1 / D6 / D5 |
| thumb outer / inner | D9 / D10 | D4 / D3 |

## Firmware

ZMK shield `prisma` in [rafaelromao/keyboards](https://github.com/rafaelromao/keyboards)
(`zmk/keyboards/rafaelromao/prisma`). It builds for `xiao_ble//zmk` with the
same keymap as the other Diamonds:

```sh
b prisma -c   # central left, peripheral left/right, dongle
```

## Regenerating

Switch mounting dimensions and manufacturer sources are recorded in
[SWITCH_MOUNT_RESEARCH.md](SWITCH_MOUNT_RESEARCH.md). Choc module openings now match
the halves' 14.0 mm CAD aperture rather than reusing the MX lid's 14.2 mm aperture.
Printed snap retention still requires qualification with the selected switches/material.

See [PRINT_READINESS.md](PRINT_READINESS.md) for the pre-print acceptance gates. Nominal
collision tests do not qualify Nylon shrinkage, support removal, magnetic retention or a one-shot print.
The linked review's claim-by-claim results and independent blind-review follow-up are in
[PREPRINT_VERIFICATION.md](PREPRINT_VERIFICATION.md).

For a mechanical blind review or print-readiness review, apply [REVIEW_CHECKLIST.md](REVIEW_CHECKLIST.md), including opposing pockets in the populated assembly.

Requires Python 3 with `requirements.txt`, podman (KiCad 9 runs in the
`docker.io/kicad/kicad:9.0` image through `kicad.sh`), and Freerouting 2.x with
Java 25.

```sh
python3 design.py        # placement, tent, outlines, magnets, screws -> design.json, design.png
FREEROUTING=/path/freerouting.jar ./route.sh   # footprints, board, routing, pours, DRC
./fab.sh                 # gerbers and drill files -> fab/prisma_jlcpcb.zip
python3 magnets.py       # only after a layout change: measures the base for the magnets to pin in design.py
python3 case.py          # base and plate STLs (and their 3D models for renders)
python3 check_fit.py     # parts, plate, solder blobs, the reset button and its cone, screws, magnets, pad slots, a USB-C plug and the lever against
                         # the case, the pads stacked, and the pads' balance: all 0 mm³, ALL CLEAR
./kicad.sh python3 check_pcb.py   # every net against its intent, and the firmware's pin lists: ALL CLEAR
python3 dock.py          # the cyberdeck dock's STL, and its fit check: all 0 mm³
python3 trackball/trackball.py && ./trackball/route.sh && ./trackball/fab.sh   # the three-board panel and gerbers
./kicad.sh python3 trackball/check_controller_pcb.py   # every pad, header pin and jumper net
python3 trackpad/trackpad.py                       # trackpad module: case and fit check
python3 insert.py                                  # the drawer's placeholder
python3 vrml.py && python3 scene.py && ./kicad.sh python3 render_boards.py && ./render.sh
python3 page.py          # index.html's BOM and build-guide sections, from BOM.md and BUILD.md
```

`layout.py` holds the Diamond geometry. `design.py` places everything else and
holds the tolerances. The outline is the fewest-facet (`GEM_FACETS`) convex
polygon around both halves joined. `XIAO_SPOT` pins the Xiao's position;
set it to `None` to search again, and if the board won't route completely, try
the runners-up the search writes to `xiao_alternatives.json`. `RESET_SPOT` pins the reset button and `BUTTON` holds its datasheet heights
and the plate's pocket and cone; `design.py` asserts its clearances. `PAD_SLOTS` pins the
pad slots the same way (`None` searches again for the slots that keep every key
centre deepest inside both halves' pads). `MAG_FLOOR_SPOTS` and `MAG_SIDE_SPOTS` pin the
magnets, found by `magnets.py` against the solid base around the pads, parts and screws.

Credits: the Choc hot-swap footprint follows [kiswitch](https://github.com/kiswitch/kiswitch)
(MIT). The Xiao pad positions follow Seeed's
[OPL KiCad library](https://github.com/Seeed-Studio/OPL_Kicad_Library). The reset button's pads follow
KiCad's `Button_Switch_SMD:SW_SPST_TL3342` from the
[official footprint library](https://gitlab.com/kicad/libraries/kicad-footprints) (CC-BY-SA 4.0), which
matches XKB's TS-1187A land pattern.
