rafaelromao/prisma/renders/modules.png

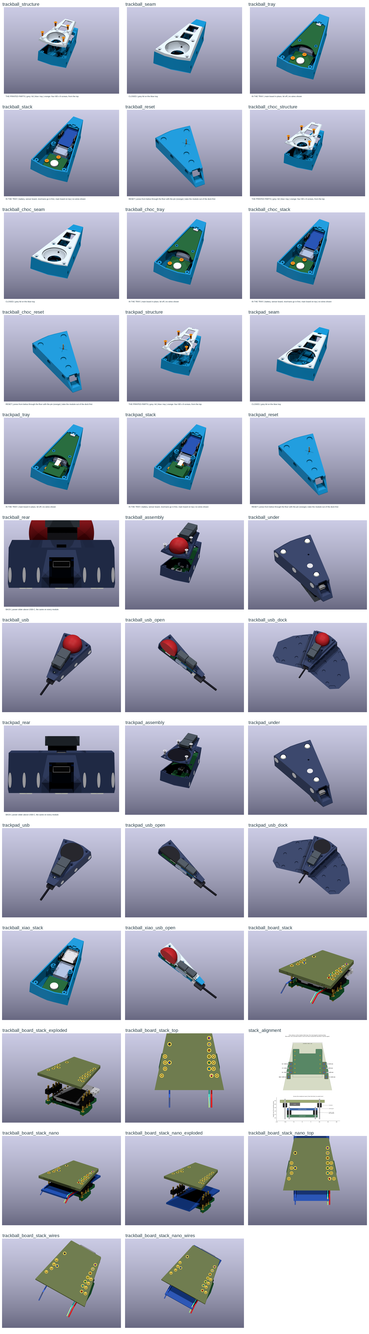
renders/modules.png
