rafaelromao/prisma/renders/trackball_choc_reset.png

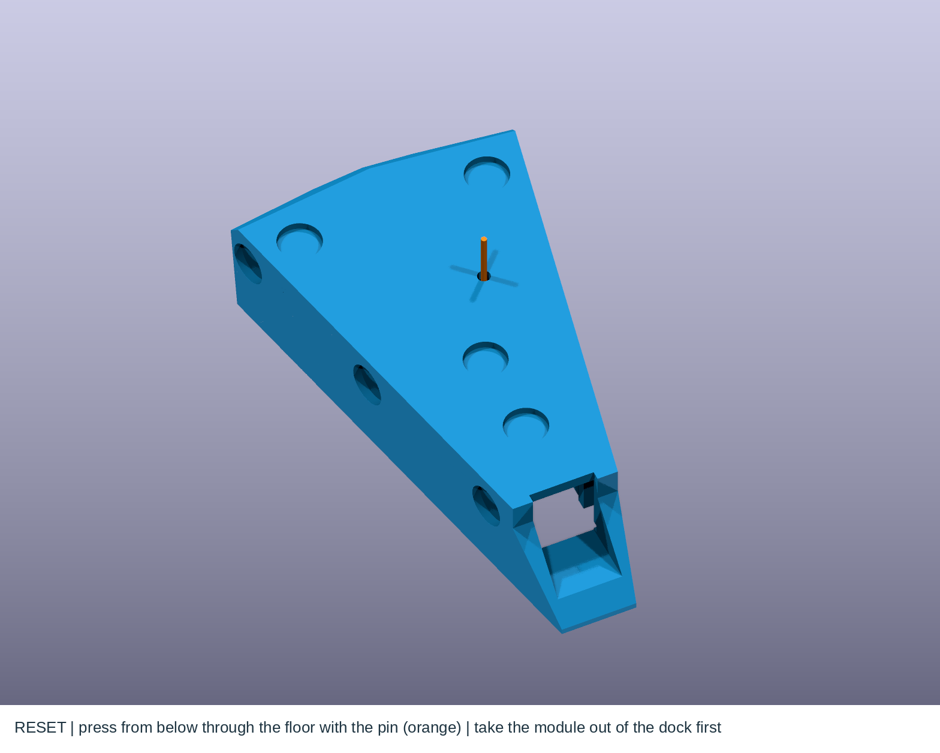
renders/trackball_choc_reset.png
