rafaelromao/prisma/renders/trackball_choc_stack.png

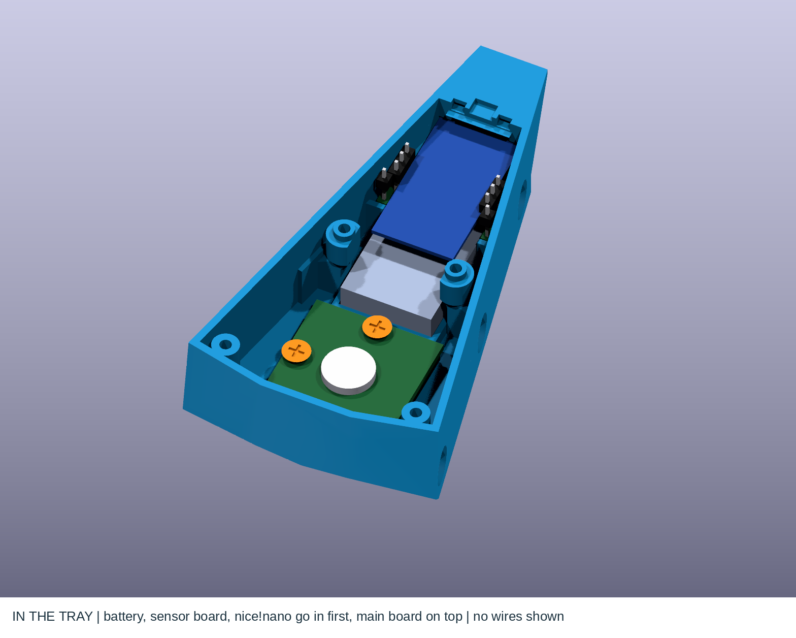
renders/trackball_choc_stack.png
