rafaelromao/prisma/renders/trackball_choc_tray.png

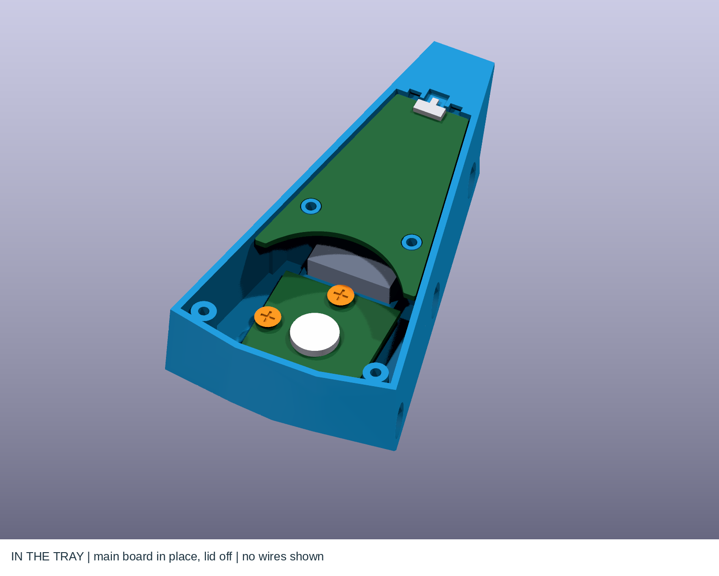
renders/trackball_choc_tray.png
