rafaelromao/prisma/renders/trackball_under.png

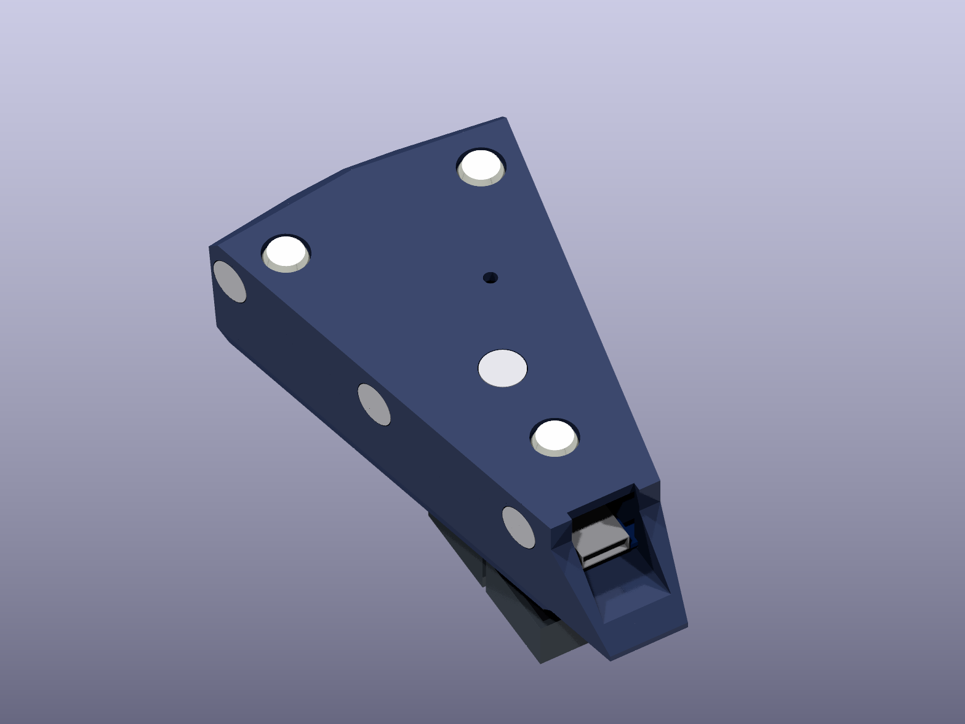
renders/trackball_under.png
