rafaelromao/prisma/case/module_tray.stl

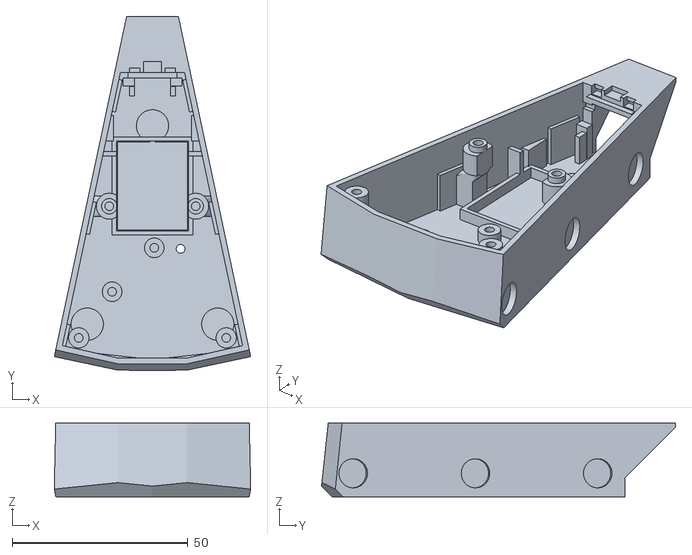
[picture p43: CAD file, 2026-11-08]
case/module_tray.stl
56.0 x 100.8 x 21.0
