rafaelromao/prisma/stls/trackball_lid_choc.stl

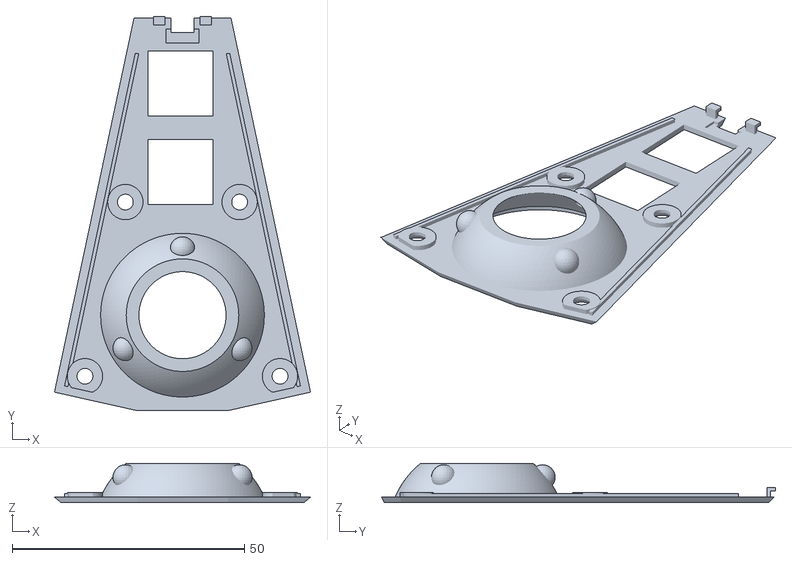
[picture p44: CAD file, 2026-11-09]
stls/trackball_lid_choc.stl
55.1 x 84.8 x 8.47
