rafaelromao/prisma/trackpad/case/lid.stl

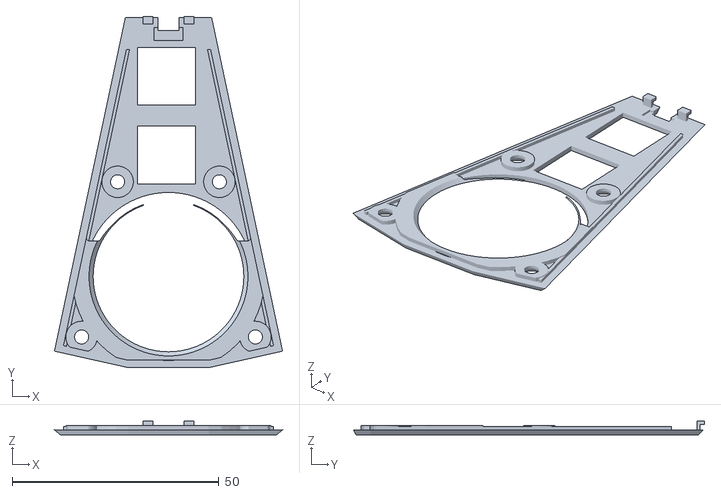
[picture p45: CAD file, 2026-11-09]
trackpad/case/lid.stl
55.1 x 84.8 x 3.28
