rafaelromao/prisma/case/case_right.stl

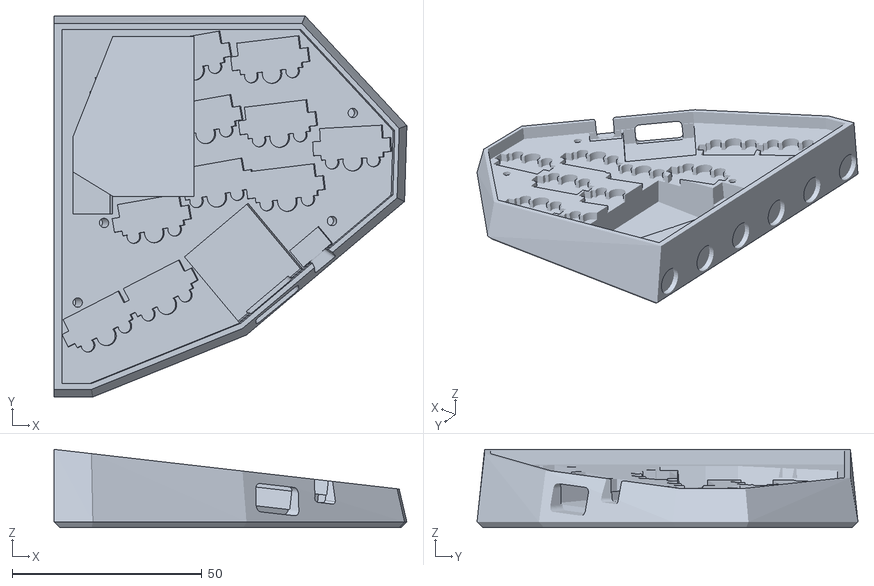
[picture p46: CAD file, 2026-11-08]
case/case_right.stl
93.0 x 100.5 x 20.6
