rafaelromao/prisma/trackball/case/lid.stl

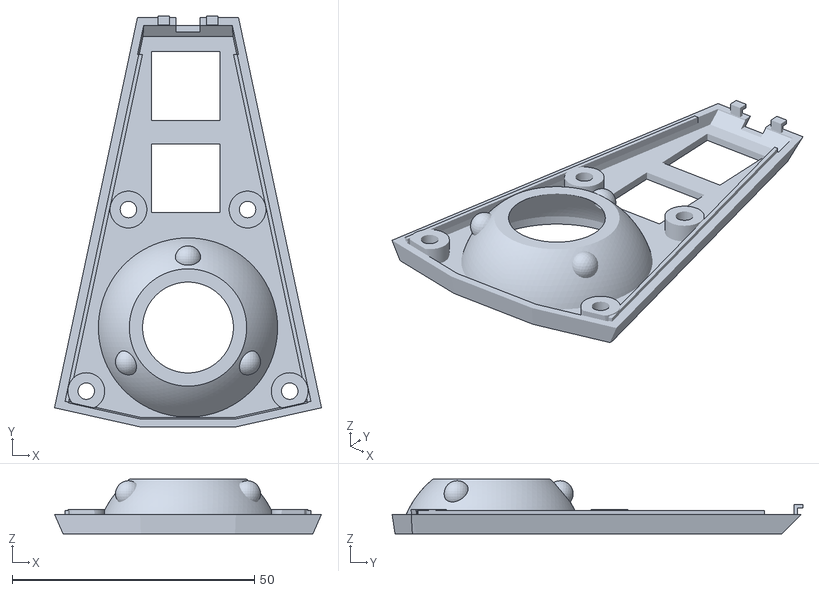
[picture p47: CAD file, 2026-11-08]
trackball/case/lid.stl
55.1 x 84.8 x 11.3
