rafaelromao/prisma/case/insert.stl

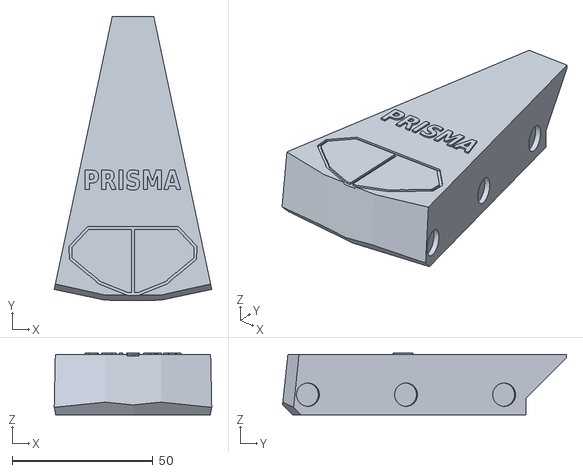
[picture p48: CAD file, 2026-11-08]
case/insert.stl
56.0 x 100.8 x 22.0
