rafaelromao/prisma/case/plate_left.stl

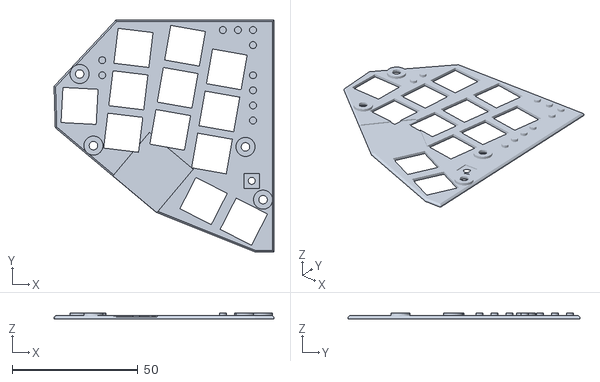
[picture p49: CAD file, 2026-11-08]
case/plate_left.stl
87.6 x 92.3 x 2.20
