rafaelromao/prisma/case/dock.stl

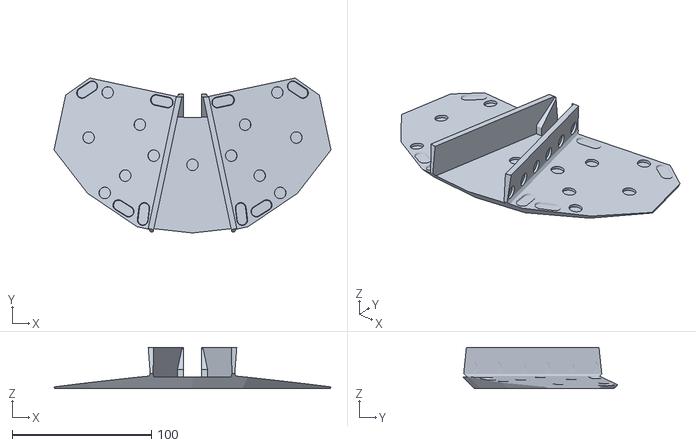
[picture p50: CAD file, 2026-11-08]
case/dock.stl
199.0 x 111.3 x 29.8
