rafaelromao/prisma/(list of files, cad)

Other CAD files:
case/case_left.stl
stls/case_left.stl
case/plate_right.stl
stls/plate_right.stl
