rafaelromao/prisma/renders/trackball_assembly.png

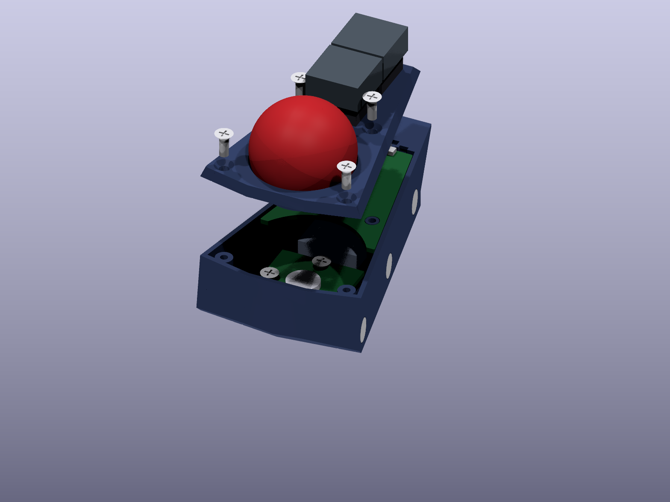
renders/trackball_assembly.png
