rafaelromao/prisma/trackball/fab/print_1to1_F_face.pdf

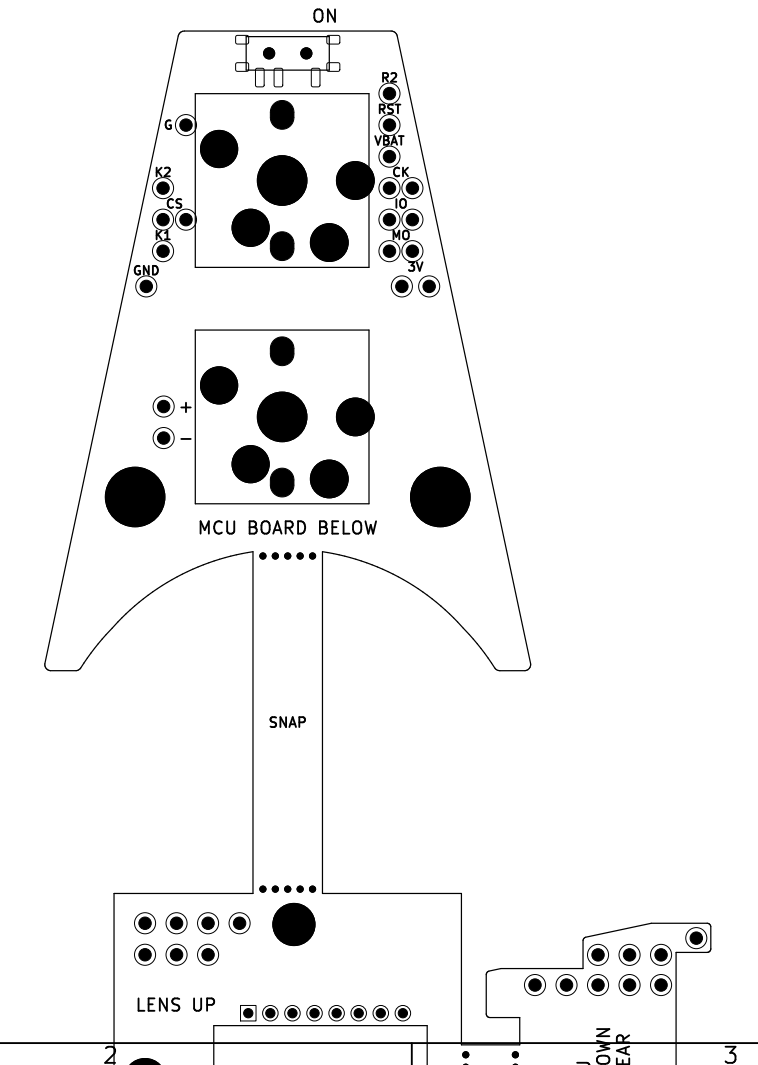
[picture p84: page 1]

3V SNAP LENS UP
Id: 1/1 Title: File: trackball.kicad_pcb Sheet: GND
