rafaelromao/prisma/fab/print_1to1_B_face.pdf

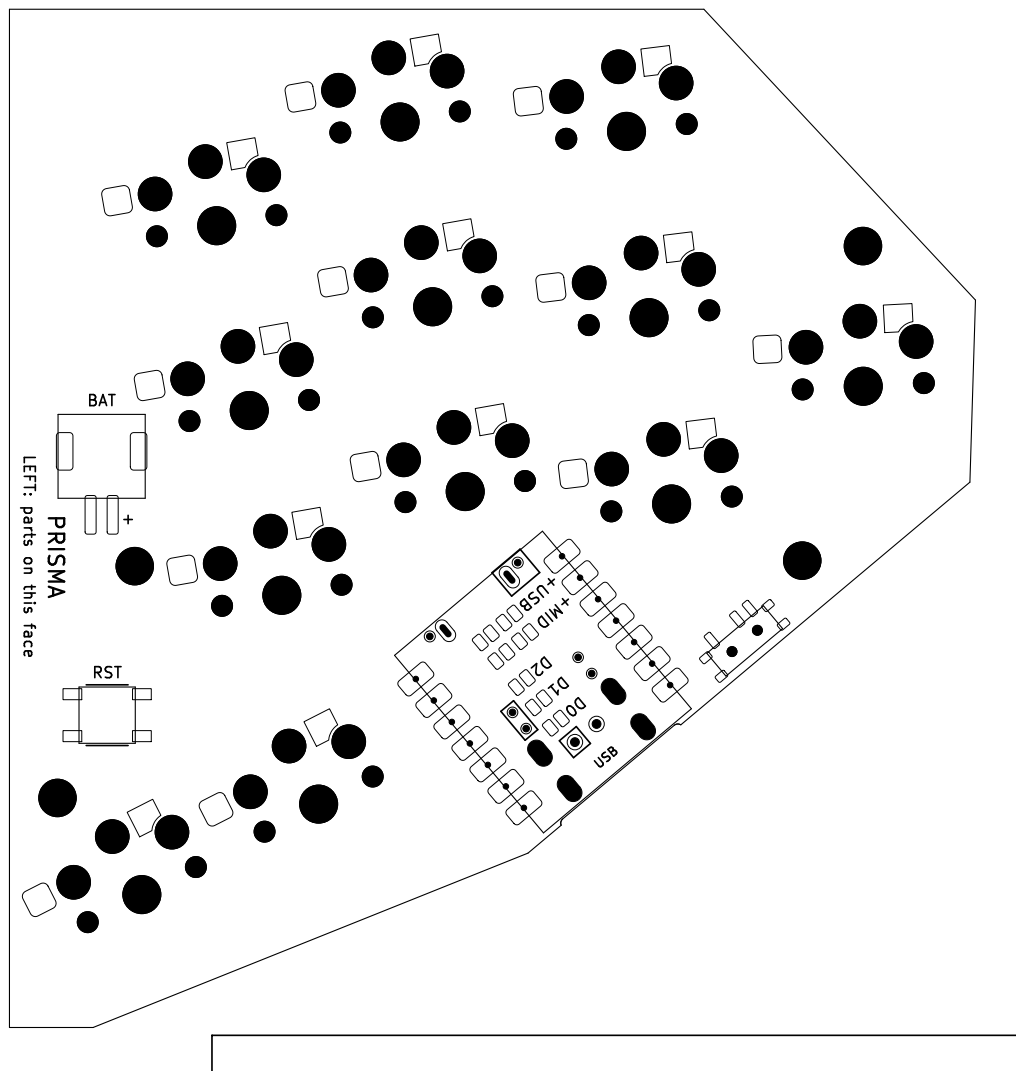
[picture p85: page 1]
