rafaelromao/prisma/fab/print_1to1_F_face.pdf

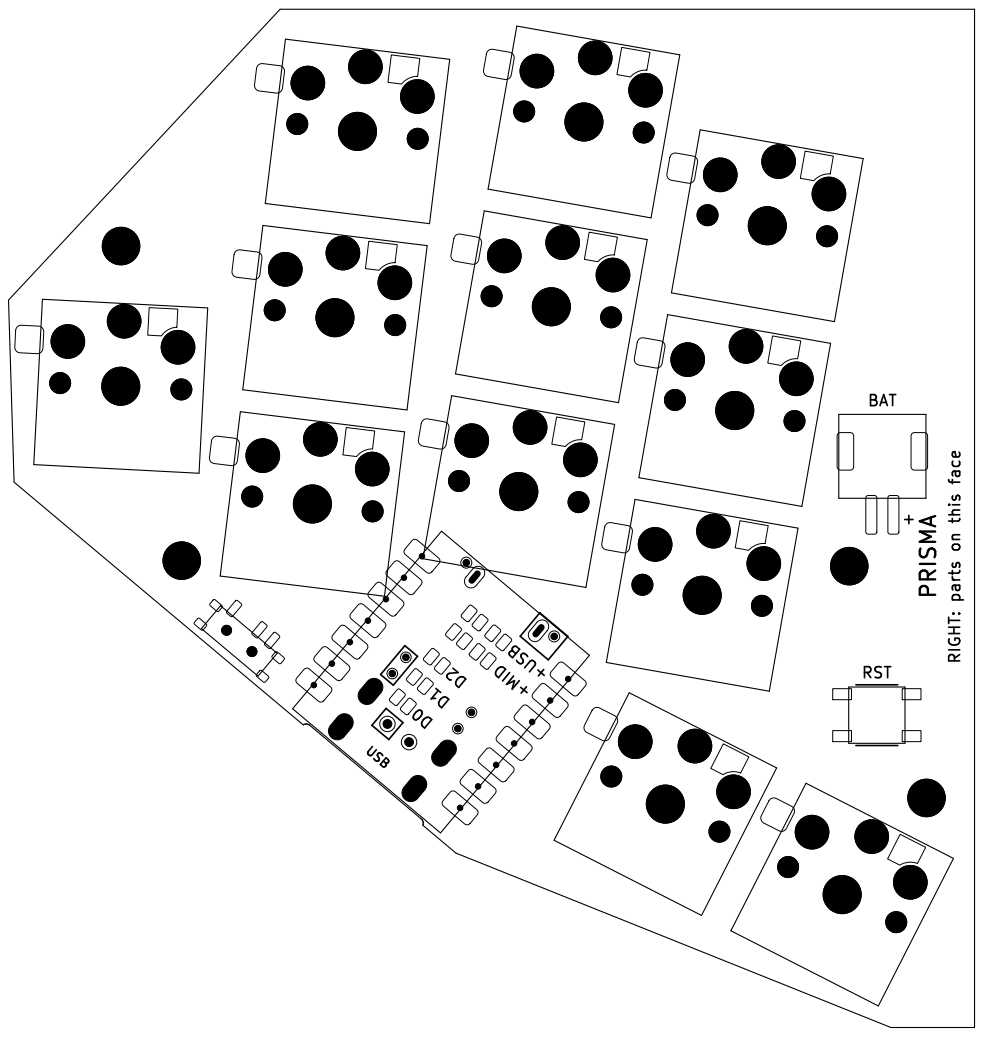
[picture p86: page 1]
