rafaelromao/prisma/pcb/prisma.kicad_pcb

## KiCad design pcb/prisma.kicad_pcb (2026-11-08)

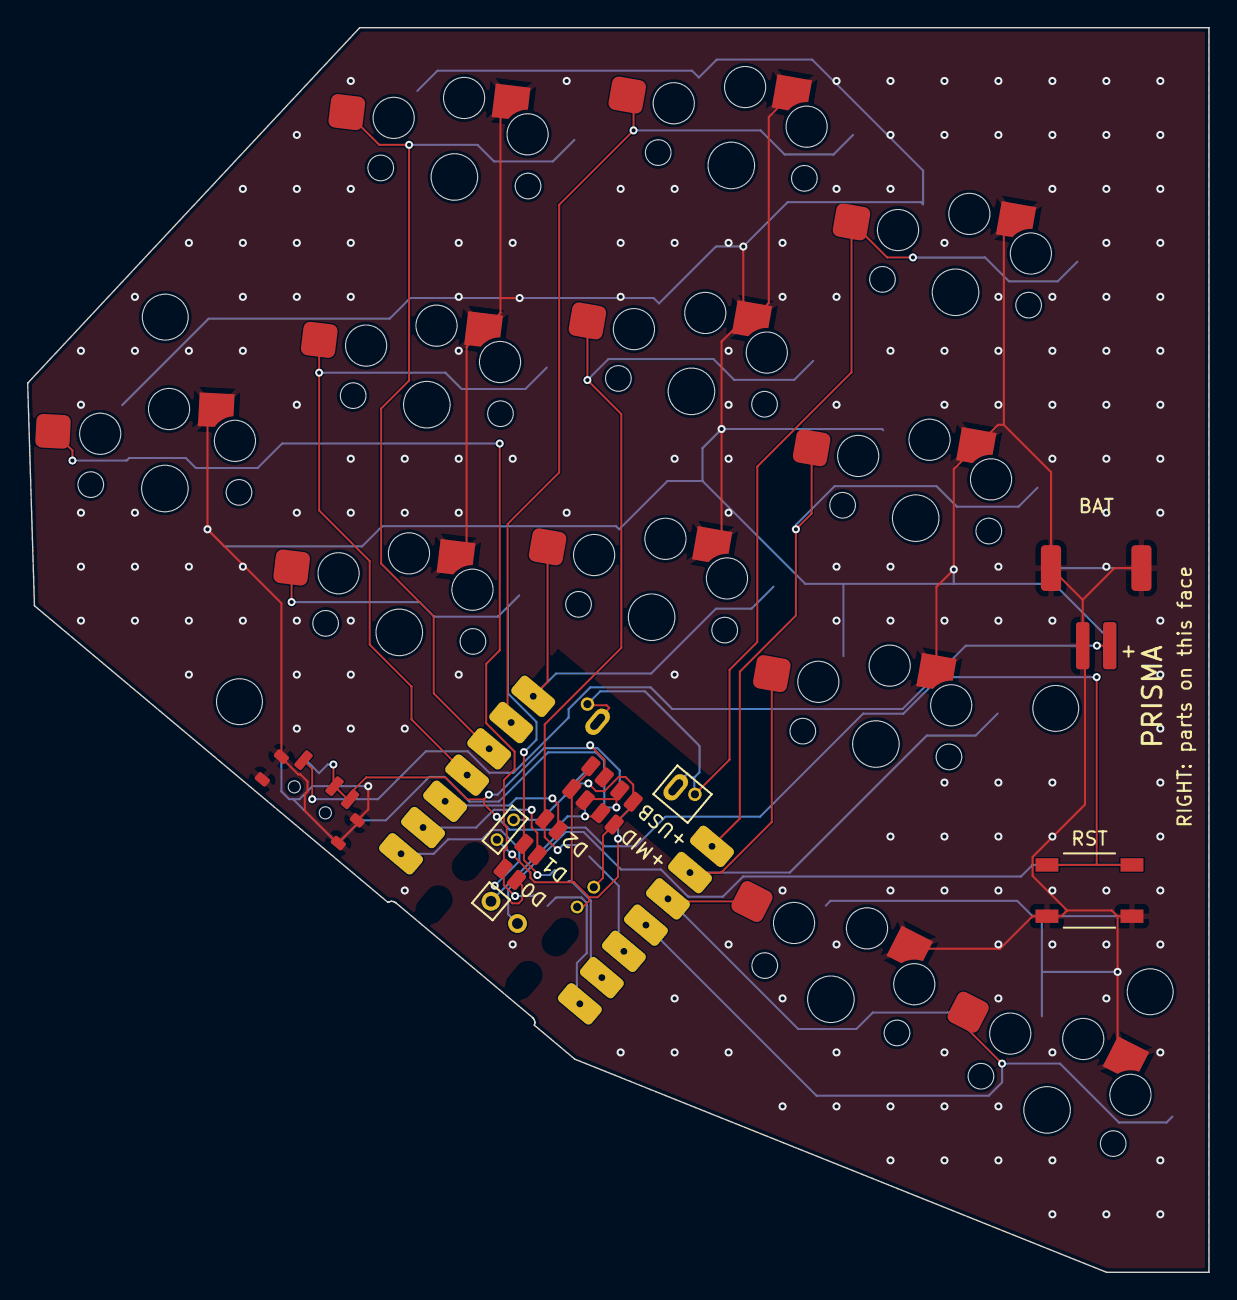
[picture p87: board prisma.kicad_pcb from above]

Board: 2 copper layers, 87.6 x 92.3 mm, 34 parts (0 on the bottom side), 25 nets.

Parts:
H1, H2, H3, H4: M3; MountingHole_M3
J1: JST PH 2.0 battery; JST_PH_S2B_Reversible
JP1: D0 left; SolderJumper_F
JP2: D1 left; SolderJumper_F
JP3: D2 left; SolderJumper_F
JP12: D2 right; SolderJumper_B
JP13: D1 right; SolderJumper_B
JP14: D0 right; SolderJumper_B
JS1: +MID BATM; SolderJumper_F
JS2: +MID BATU; SolderJumper_F
JS3: +MID BATM; SolderJumper_B
JS4: +MID BATU; SolderJumper_B
JS5: +USB BATM; SolderJumper_F
JS6: +USB BATU; SolderJumper_F
JS7: +USB BATM; SolderJumper_B
JS8: +USB BATU; SolderJumper_B
SW1: pinky; SW_Choc_V1_Hotswap_Reversible
SW2: ring_top; SW_Choc_V1_Hotswap_Reversible
SW3: ring_home; SW_Choc_V1_Hotswap_Reversible
SW4: ring_bottom; SW_Choc_V1_Hotswap_Reversible
SW5: middle_top; SW_Choc_V1_Hotswap_Reversible
SW6: middle_home; SW_Choc_V1_Hotswap_Reversible
SW7: middle_bottom; SW_Choc_V1_Hotswap_Reversible
SW8: index_top; SW_Choc_V1_Hotswap_Reversible
SW9: index_home; SW_Choc_V1_Hotswap_Reversible
SW10: index_bottom; SW_Choc_V1_Hotswap_Reversible
SW11: thumb_outer; SW_Choc_V1_Hotswap_Reversible
SW12: thumb_inner; SW_Choc_V1_Hotswap_Reversible
SW13: MSK-12C02; SW_MSK12C02_Reversible
SW14: TS-1187A reset; SW_TS1187A_Reversible
U1: XIAO nRF52840 / Super52840; nRF52840_Module_Reversible

Connections:
BAT+: J1.1, SW13.1
BATM: JS1.1, JS3.2, JS5.1, JS7.2, U1.BATM
BATU: JS2.2, JS4.1, JS6.2, JS8.1, U1.BATU
GND: J1.2, J1.MP, JS2.1, JS4.2, JS5.2, JS7.1, SW1.1, SW2.1, SW3.1, SW4.1, SW5.1, SW6.1, SW7.1, SW8.1, SW9.1, SW10.1, SW11.1, SW12.1, SW13.SH, SW14.2, SW14.4
K_index_bottom: SW10.2, U1.L9
K_index_home: SW9.2, U1.L8
K_index_top: SW8.2, U1.NFC1
K_middle_bottom: SW7.2, U1.L7
K_middle_home: JP3.2, JP12.2, SW6.2
K_middle_top: SW5.2, U1.L6
K_pinky: JP1.2, JP14.2, SW1.2
K_ring_bottom: JP2.2, JP13.2, SW4.2
K_ring_home: SW3.2, U1.L4
K_ring_top: SW2.2, U1.L5
K_thumb_inner: SW12.2, U1.L11
K_thumb_outer: SW11.2, U1.L10
RST_L: SW14.1, U1.RSTL
RST_R: SW14.3, U1.RSTR
VBAT: JS1.2, JS3.1, JS6.1, JS8.2, SW13.2, SW13.3
X_L1: JP1.1, U1.L1
X_L2: JP2.1, U1.L2
X_L3: JP3.1, U1.L3
X_L12: JP12.1, U1.L12
X_L13: JP13.1, U1.L13
X_L14: JP14.1, U1.L14
