rafaelromao/prisma/trackball/pcb/trackball.kicad_pcb

## KiCad design trackball/pcb/trackball.kicad_pcb (2026-11-07)

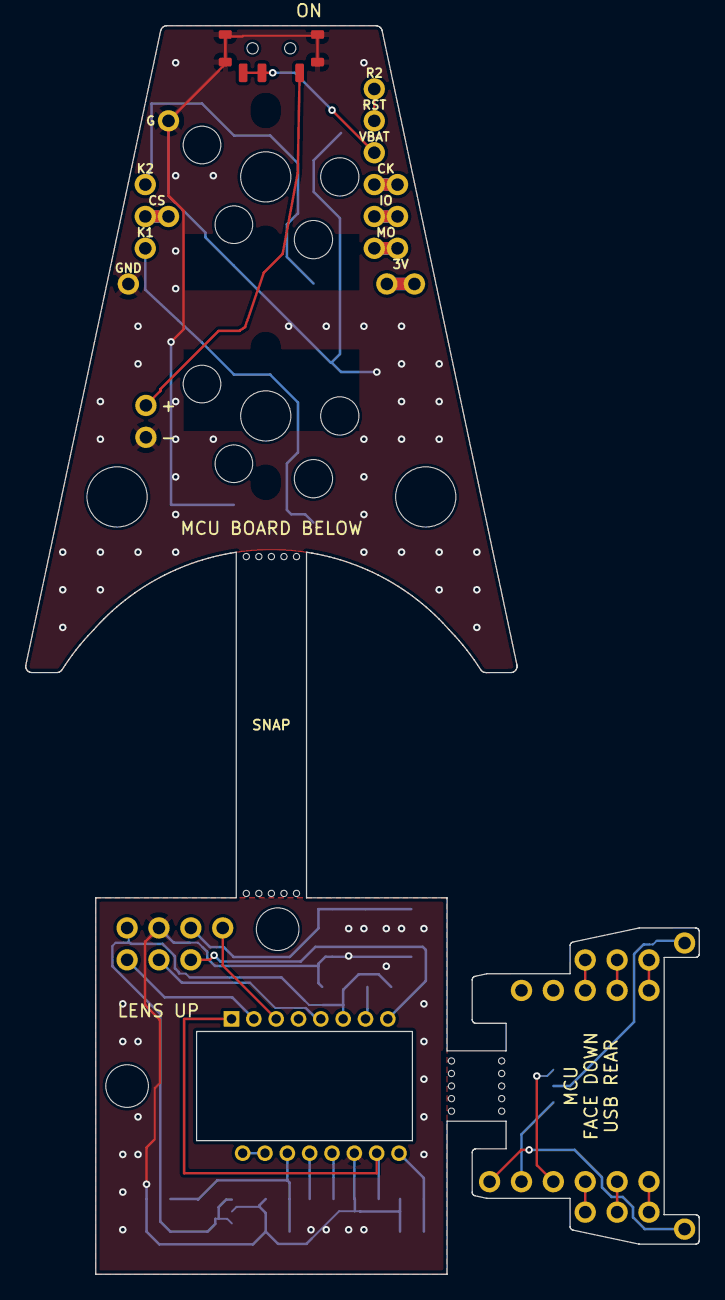
[picture p88: board trackball.kicad_pcb from above]

Board: 2 copper layers, 53.7 x 99.5 mm, 86 parts (0 on the bottom side), 35 nets.

Parts:
H1, H2: post; PostHole
J1: SCLK; WirePad
J2: SDIO; WirePad
J3: NCS; WirePad
J4: MOTION; WirePad
J5: RST; WirePad
J6: VCC; WirePad
J7, J9: GND; WirePad
J8: BAT+; WirePad
J10: VBAT; WirePad
J11: R2; WirePad
JP1: 3V: XIAO or nice!nano; SolderJumper3_Back
L1: L5; WirePad
L2: L6; WirePad
L3: L7; WirePad
L4: L8; WirePad
L5: R5; WirePad
L6: R6; WirePad
L7: R7; WirePad
L8: R8; WirePad
MB1, MB2, MB3, MB4, MB5, MB6, MB7, MB8, MB9, MB10, MB11, MB12, MB13, MB14, MB15, MB16, MB17, MB18, MB19, MB20: bite; MouseBite
ML1: L5; WirePad
ML2: L6; WirePad
ML3: L7; WirePad
ML4: L8; WirePad
ML5: R5; WirePad
ML6: R6; WirePad
ML7: R7; WirePad
ML8: R8; WirePad
MP1: L2; WirePad
MP2: L3; WirePad
MP3: L4; WirePad
MP4: L5; WirePad
MP5: L6; WirePad
MP6: L7; WirePad
MP7: R3; WirePad
MP8: R4; WirePad
MP9: R5; WirePad
MP10: R6; WirePad
MP11: R7; WirePad
S1: PMW3610DM-SUDU + LM18-LSI; PMW3610_Back
S2: TLV74318PDBVR; SOT-23-5_Back
S3: TS-1187A reset; SW_TS1187A_Back
SC1: 3.3uF; C_0805_Back
SC2, SC3, SC4: 100nF; C_0805_Back
SC5, SC7: 10nF; C_0805_Back
SC6: 10uF; C_0805_Back
SC8, SC9: 1uF; C_0805_Back
SH1, SH2: M3; MountingHole_M3
SJ1: VCC; WirePad
SJ2: GND; WirePad
SJ3: RST; WirePad
SJ4: SCLK; WirePad
SJ5: SDIO; WirePad
SJ6: NCS; WirePad
SJ7: MOTION; WirePad
SR1: 10k; C_0805_Back
SW1: MX / Choc v1 key 1; SW_MX_Choc_V1_Hotswap
SW2: MX / Choc v1 key 2; SW_MX_Choc_V1_Hotswap
SW3: MSK-12C02 power; SW_MSK12C02

Connections:
BAT+: J8.1, SW3.1
GND: J7.1, J9.1, L4.1, SW1.1, SW2.1, SW3.SH
K1: L3.1, SW1.2
K2: L1.1, SW2.2
MOTION: J4.1, L7.1
M_3V: JP1.2, ML8.1
M_CK: ML5.1, MP9.1
M_CS: ML2.1, MP5.1
M_GND: ML4.1, MP1.1
M_IO: ML6.1, MP10.1
M_K1: ML3.1, MP6.1
M_K2: ML1.1, MP4.1
M_L3: JP1.1, MP2.1
M_L4: JP1.3, MP3.1
M_MO: ML7.1, MP11.1
NCS: J3.1, L2.1
RST: J5.1, J11.1
SCLK: J1.1, L5.1
SDIO: J2.1, L6.1
S_CN: S1.13, SC4.2
S_CP: S1.12, SC4.1
S_GND: S1.11, S2.2, S3.2, SC1.2, SC2.2, SC3.2, SC5.2, SC6.2, SC7.2, SC8.2, SC9.2, SJ2.1
S_MOTION: S1.8, SJ7.1
S_NCS: S1.5, SJ6.1
S_NRST_S: S1.7, SR1.2
S_RST: S3.1, SJ3.1
S_SCLK: S1.3, SJ4.1
S_SDIO: S1.2, SJ5.1
S_V1V8: S1.14, S2.5, SC1.1, SC2.1, SC9.1
S_VCC: S1.6, S2.1, S2.3, SC3.1, SC8.1, SJ1.1, SR1.1
S_VCP: S1.9, SC6.1, SC7.1
S_VCSEL: S1.1, S1.10, SC5.1
S_XYL: S1.15, S1.16
VBAT: J10.1, SW3.2, SW3.3
VCC: J6.1, L8.1
