rafaelromao/prisma/module_shell.py

"""A module for the dock's drawer: the tray and lid every module shares.

Frame: the dock's plan (x right, y away from you, mm); z up from the plane the module stands on,
the desk or the drawer's floor. Its bump-on feet are FEET tall, so its body starts at z = FEET.

The outline is the drawer's, DRAWER_CLR in (dock.module_plan), so any module fits. The walls are
vertical at the sides, with the halves' exact facets at the front: in the dock they meet its
wedge-shaped walls (vertical inside, leaning with the halves outside), and on the desk a half's own
vertical inner wall, so a module sits flat against either. Three magnets per side (dock.DRAWER_MAGS)
sit where the halves' inner-wall magnets do, at the same height over the plane both stand on: the
module on its feet, a half on its pads. Pressed in from outside, flush, like the case's, each backed
by a boss. In the dock they meet its thin magnets through the inner retaining skin; independently
they meet the halves directly.

A module is built like a half: a tray (floor, walls, posts) printed floor down, and a lid printed
top down. The tray ends at the halves' top edges (FLUSH) and is the same print for every module; the
lids differ. Four of the halves' M3 x 8 flat-head screws go in from the top, into countersinks in
the lid and on into the tray's four posts. The two side posts come up through the main board, which
rests on their shoulders, so the screw length doesn't depend on the lid's height.
"""
import math
from functools import lru_cache

import numpy as np
from manifold3d import CrossSection, FillRule, Manifold
from shapely.geometry import LineString, Point, Polygon, box
from shapely import affinity
from shapely.ops import unary_union

import dock as K

P = K.placement()
OUTLINE = K.module_plan(P)
FEET = K.MODULE_FEET
WALL = 1.6
BOTTOM_T = 2.2                     # foot roofs are reinforced locally to 1.1 mm
PCB_T = 1.6
BEVEL_WALL = 1.0                   # the wall under the bevel, square to it (2.5 perimeters at 0.4 mm)
UPPER_BEVEL = 1.5                  # maximum 45-degree rim width; retain material round rear switch holes
FRONT_BEVEL = .6                   # steeper front facet retains the 40 mm pad's rim and key/power clearance
LID_CLR = 0.25                     # round the lid's locating lip, inside the walls
MAG_D, MAG_H = K.D["magnet_side_size"]          # common disc pocket, with fit clearance
MAG_Z = K.D["magnet_side_z"] + K.PAD_DROP       # over the standing plane: a half's, on its pads
BOSS = (MAG_D + 1.0, MAG_H + 0.1 + 0.9)         # 0.9 mm backing, glue-clearance installation
_S = K.D["screw"]                  # the halves' M3 x 8 flat head (90-degree countersunk)
SCREW = dict(pilot=_S["pilot_d"], post=5.8, head=_S["head_d"], hole=_S["pcb_hole"],
             boss=_S["boss_d"], length=_S["length"], cone=1.5, head_h=1.65)
FRONT_SCREW = (21.0, -91.5)        # front posts only (no PCB holes); >2 mm from head to pad seat
PCB_SCREW = (12.3, -54.0)          # through the main board, beside the first key; far enough back to leave the trackpad's seat a web
BUMPON = (8.0, 2.0)                # the case's 8 x 2 mm bump-ons, recessed to stand FEET proud
SPINE_TOP = K.spine_height(P)
FLOOR_Z = K.drawer_floor(P)        # the drawer's floor over the desk
FLUSH = SPINE_TOP - FLOOR_Z        # the tray's top: level with the halves' top edges
PCB_TOP = FLUSH - 1.0              # main board's top: 1.0 mm under the lid, as a half's plate gap
CHOC_TOP = PCB_TOP + 2.2           # the Choc and trackpad lids' top


def lid_screws():
    (fx, fy), (px, py) = FRONT_SCREW, PCB_SCREW
    return [(-fx, fy), (fx, fy), (-px, py), (px, py)]


def extrude(poly, z0, z1):
    polys = getattr(poly, "geoms", [poly])
    rings = []
    for p in polys:
        rings.append(list(p.exterior.coords)[:-1])
        rings += [list(i.coords)[:-1] for i in p.interiors]
    return CrossSection(rings, FillRule.EvenOdd).extrude(z1 - z0).translate((0, 0, z0))


def inner():
    return OUTLINE.buffer(-WALL, join_style=2)


def profile(height):
    """The actual outer plan at height above the module's standing plane."""
    return K.module_plan(P, FLOOR_Z + height)


def lid_top_plan(height):
    """Upper rim drawn in from the actual halves-height front, not its lower envelope."""
    return upper_inset(profile(FLUSH), min(height - FLUSH, UPPER_BEVEL))


def upper_inset(poly, inset):
    """Side inset, with a shallower horizontal setback at the front (same full-height facet)."""
    top = poly.buffer(-inset, join_style=2)
    front = min(inset, FRONT_BEVEL)
    if front < inset:
        top = unary_union([top, affinity.translate(top, yoff=front - inset)]).convex_hull
    return top


def magnets():
    """Each magnet's place on the module's outer wall: (point (x, y), outward normal), both sides."""
    out = []
    ring = OUTLINE.exterior
    for m in K.drawer_magnets(P):
        for sx in (1, -1):
            q = np.array((sx * m[0], m[1]))
            w = np.array(ring.interpolate(ring.project(Point(q))).coords[0])
            n = (q - w) / np.linalg.norm(q - w)
            out.append((w, n))
    return out


def _along(w, n, length, depth):
    """A rectangle on the wall at w: `length` along it, `depth` in from the outer face."""
    t = np.array((-n[1], n[0]))
    a = w - t * length / 2
    b = w + t * length / 2
    return Polygon([tuple(a), tuple(b), tuple(b - n * depth), tuple(a - n * depth)])


def magnet_bosses():
    return [_along(w, n, *BOSS) for w, n in magnets()]


def magnet_pockets():
    out = Manifold()
    for w, n in magnets():
        c = Manifold.cylinder(MAG_H + 0.1 + 0.01, MAG_D / 2, circular_segments=40)
        ang = math.degrees(math.atan2(-n[1], -n[0]))
        c = c.rotate((0, 90, 0)).rotate((0, 0, ang))          # along -n, into the wall
        out += c.translate((w[0] + n[0] * 0.01, w[1] + n[1] * 0.01, MAG_Z))
    return out


def room():
    """Inside the walls, clear of the magnet bosses (with 0.3 mm round them)."""
    return inner().difference(unary_union(magnet_bosses()).buffer(0.3))


@lru_cache(maxsize=1)
def service_plan():
    """The floor's plan inside the narrowest, lowest front facet: where the feet can go."""
    column = K.module_front(extrude(inner().buffer(-LID_CLR, join_style=2), FEET - 0.1, FEET + 0.1),
                            P, WALL + LID_CLR)
    plan = Polygon()
    for ring in column.slice(FEET).to_polygons():
        plan = plan.symmetric_difference(Polygon(ring))
    return plan


def feet_spots():
    """Bump-ons under the floor: the front corners and the back, inset to stay on it."""
    ok = service_plan().buffer(-BUMPON[0] / 2 - 1.0)
    # Keep the rear recess in front of the USB overmold passage, retaining its full roof.
    ok = ok.intersection(box(-200, -200, 200, -31.0))
    x0, y0, x1, y1 = ok.bounds
    pts = [(x, y) for x in np.arange(x0, x1 + 0.01, 0.5) for y in np.arange(y0, y1 + 0.01, 0.5)
           if ok.contains(Point(x, y))]
    front_l = min(pts, key=lambda q: q[1] + 0.6 * q[0])
    back = max(pts, key=lambda q: q[1])
    return [front_l, (-front_l[0], front_l[1]), (0.0, back[1])]


def tray():
    """The shared tray: floor, walls and magnet bosses, up to FLUSH, with the rear hood.
    Printed floor down, so the hood's 45-degree underside needs no support."""
    body = K.module_front(extrude(OUTLINE, FEET, FLUSH), P)
    body -= K.module_front(extrude(inner(), FEET + BOTTOM_T, FLUSH + 1), P, WALL)
    for b in magnet_bosses():
        body += extrude(b, FEET + BOTTOM_T - 0.01, MAG_Z + MAG_D / 2 + 1.5) ^ extrude(OUTLINE, 0, FLUSH)
    body = K.module_front(body, P) + rear_hood()
    d, h = BUMPON
    for x, y in feet_spots():
        body += Manifold.cylinder(.41, d / 2 + .6, circular_segments=40).translate(
            (x, y, FEET + BOTTOM_T - .01))
        body -= Manifold.cylinder(h - FEET + 0.01, d / 2 + 0.2, circular_segments=40).translate((x, y, FEET - 0.01))
    x, y = K.DRAWER_FLOOR_MAG
    body += Manifold.cylinder(2.5, 4.8, circular_segments=48).translate((x, y, FEET))
    body -= Manifold.cylinder(1.61, 4.15, circular_segments=48).translate((x, y, FEET - .01))
    return body - magnet_pockets() - finger_pockets()


FINGERS = (-5.0, 5.0)              # the lid's rear hooks: no screw head fits behind the keys


def finger_pockets():
    """Open-top channels in the rear wall, undercut for the lid's hooks. The lid goes on rear
    first, tilted; closing it swings the hooks' toes under the wall."""
    back = OUTLINE.bounds[3] - WALL
    out = Manifold()
    for x in FINGERS:
        out += Manifold.cube((3.0, 1.3, 3)).translate((x - 1.5, back - .05, FLUSH - 2.3))
        out += Manifold.cube((3.0, 2.15, 1.2)).translate((x - 1.5, back - .05, FLUSH - 2.3))
    return out


def lid_blank(height, top_t):
    """The lid's top and, on a tall lid, its short walls, a locating lip inside the tray's rim, the
    rear hooks, and a boss down to the main board's top at every screw. The module's own openings
    are cut by its script; finish with `lid_holes`."""
    body = K.module_front(extrude(OUTLINE, FLUSH, height) ^ bevel_hull(OUTLINE, height), P)
    if height - top_t > FLUSH + .01:
        # the inside follows the facet, keeping BEVEL_WALL of wall under it
        under = height - top_t
        outer = min(height - FLUSH, UPPER_BEVEL) * (under - FLUSH) / (height - FLUSH)
        cavity = extrude(inner(), FLUSH - 1, under) ^ bevel_hull(
            inner(), under, FLUSH, inset=max(outer + BEVEL_WALL - WALL, .01),
            rear_start=FLUSH + WALL - BEVEL_WALL * math.sqrt(2), front_inset=WALL)
        body -= K.module_front(cavity, P, WALL)
    lip = inner().buffer(-LID_CLR, join_style=2).difference(inner().buffer(-1.0, join_style=2))
    lip = lip.intersection(box(-99, -200, 99, -22))
    body += K.module_front(extrude(lip, PCB_TOP + .2, FLUSH + .01), P, WALL + LID_CLR)
    if height - top_t > FLUSH + .01:         # a tall lid's walls stand off the lip: tie them together
        flange = inner().buffer(.05, join_style=2).difference(inner().buffer(-1.0, join_style=2))
        body += K.module_front(extrude(flange.intersection(box(-99, -200, 99, -22)), FLUSH, FLUSH + .6), P, WALL - .05)
    back = OUTLINE.bounds[3] - WALL
    for x in FINGERS:
        body += Manifold.cube((2.4, .75, 2.1)).translate((x - 1.2, back + .05, FLUSH - 2.08))
        body += Manifold.cube((2.4, 1.85, .8)).translate((x - 1.2, back + .05, FLUSH - 2.08))
    plate = height - top_t
    for x, y in lid_screws():
        boss = Point(x, y).buffer(SCREW["boss"] / 2, 32).intersection(inner().buffer(-LID_CLR, join_style=2))
        body += K.module_front(extrude(boss, PCB_TOP, plate + .01), P, WALL + LID_CLR)
    return body


def lid_holes(m, height):
    """Clearance holes and countersinks, as on the halves' plates: a plain 90-degree cone in the
    lid's top, the head flush."""
    for x, y in lid_screws():
        r = SCREW["head"] / 2
        m -= Manifold.cylinder(height + 1, SCREW["hole"] / 2, circular_segments=32).translate((x, y, PCB_TOP - .5))
        cone = Manifold.cylinder(SCREW["cone"] + .01, SCREW["hole"] / 2, r + .01, circular_segments=48)
        m -= cone.translate((x, y, height - SCREW["cone"]))
    return m


def rear_hood():
    """Top-only rear extension, part of the shared tray.
    Its underside rises one millimetre per millimetre rearwards; the dock keeps the
    matching support underneath. Forward removal increases the gap rather than hooking.
    """
    blank = extrude(K.rear_hood_plan(P), FEET, FLUSH)
    normal = (0, -1 / math.sqrt(2), 1 / math.sqrt(2))
    return blank.trim_by_plane(normal, K.rear_hood_datum(P) / math.sqrt(2))


def bevel_hull(poly, top, start=None, rear_start=None, inset=None, front_inset=0.0):
    """From `start` (the halves' top edges, FLUSH) up to `top`, the outline drawn in by at most
    UPPER_BEVEL: one flat facet all the way, 45 degrees on a low lid, steeper on a tall one, so the
    keys and screw heads keep their rim. Below it, the outline."""
    start = FLUSH if start is None else start
    b = min(top - start, UPPER_BEVEL) if inset is None else inset
    ring = lambda p, z: [(x, y, z) for x, y in p.exterior.coords[:-1]]
    # A small outward allowance avoids coincident hull/front-plane faces on STL quantization.
    base = poly.intersection(profile(start).buffer(-front_inset + .005, join_style=2))
    solid = (extrude(poly, -1, top + 1) if b <= 0 else
             Manifold.hull_points(ring(poly, -1) + ring(base, start) + ring(upper_inset(base, b), top)))
    # The raised rear shoulder meets the common hood at 45 degrees too. Unlike
    # the narrow side bevel, this slope spans the full height difference.
    datum = poly.bounds[3] + (FLUSH if rear_start is None else rear_start)
    return solid.trim_by_plane((0, -1 / math.sqrt(2), -1 / math.sqrt(2)), -datum / math.sqrt(2))


def bevel(m, height):
    """A module's solid trimmed to its bevel (the shell and anything added to it)."""
    return K.module_front(m ^ (bevel_hull(OUTLINE, height) + rear_hood()), P)


def floor_magnet():
    x, y = K.DRAWER_FLOOR_MAG
    return Manifold.cylinder(1.5, 4, circular_segments=48).translate((x, y, FEET + .05))


def bumpons():
    d, h = BUMPON
    out = Manifold()
    for x, y in feet_spots():
        out += Manifold.cylinder(h, d / 2 - 0.8, d / 2, circular_segments=40).translate((x, y, 0))
    return out


def flat_screw(x, y, head_z, length=None):
    """The halves' M3 x 8, 90-degree flat head, driven from above; head_z is its top face.
    Its thread forms in the pilot, so the modelled shank overlaps the plastic on purpose."""
    length = SCREW["length"] if length is None else length
    head = Manifold.cylinder(SCREW["head_h"], 1.5, 3.0, circular_segments=40).translate((0, 0, -SCREW["head_h"]))
    shank = Manifold.cylinder(length - SCREW["head_h"], 1.5, circular_segments=32).translate(
        (0, 0, -length))
    cross = Manifold.cube((3.4, .6, .5)).translate((-1.7, -.3, -.49))
    cross += Manifold.cube((.6, 3.4, .5)).translate((-.3, -1.7, -.49))
    return ((head + shank) - cross).translate((x, y, head_z))


def lid_fasteners(height, lift=0.0):
    out = Manifold()
    for x, y in lid_screws():
        out += flat_screw(x, y, height + lift)
    return out


def usb_connection(front, z):
    """Illustrative straight USB-C plug, fully seated: metal, overmold and cable.
    Dimensions match the keyboard's conservative 12.35 x 6.5 mm overmold envelope.
    `front` is the receptacle's front face; insertion extends 6 mm into the receptacle.
    """
    metal = Manifold.cube((8.4, 7.0, 2.6)).translate((-4.2, front - 6.0, z - 1.3))
    body = Manifold.cube((12.35, 16.0, 6.5)).translate((-6.175, front + 1.0, z - 3.25))
    cable = Manifold.cylinder(30.0, 1.8, circular_segments=32).rotate((-90, 0, 0)).translate(
        (0, front + 17.0, z))
    return metal, body, cable


def usb_clearance(front, z):
    """Cable-plug passage from the receptacle to outside the rear wall, with fit allowance."""
    return Manifold.cube((12.8, OUTLINE.bounds[3] - front + 20, 7.2)).translate(
        (-6.4, front + 0.8, z - 3.6))


def check_common(name, lid_m, tray_m, parts):
    """The checks every module needs: every part against the lid, the tray and the others; the
    module in the dock's drawer, against the dock and the halves; on the desk against a half."""
    def vol(a, b):
        return (a ^ b).volume()
    print(name)
    print("  lid x tray                 %.3f mm3" % vol(lid_m, tray_m))
    assert abs(vol(lid_m, tray_m)) < 1e-3, "lid interferes with the tray"
    for pname, pm in parts:
        print("  %-26s %.3f mm3 x lid, %.3f x tray" % (pname, vol(pm, lid_m), vol(pm, tray_m)))
        assert abs(vol(pm, lid_m)) < 1e-3 and abs(vol(pm, tray_m)) < 1e-3, pname
    body = extrude(OUTLINE, 0, 99)
    for w, n in magnets():
        c = Manifold.cylinder(MAG_H + 0.1, MAG_D / 2 + 0.5, circular_segments=40)
        ang = math.degrees(math.atan2(-n[1], -n[0]))
        c = c.rotate((0, 90, 0)).rotate((0, 0, ang)).translate((w[0], w[1], MAG_Z))
        print("  magnet at (%5.1f, %5.1f): its pocket's 0.5 mm surround %.2f mm3 outside the module" %
              (w[0], w[1], (c - body).volume()))
    names = [n for n, _ in parts]
    for i in range(len(parts)):
        for j in range(i + 1, len(parts)):
            v = vol(parts[i][1], parts[j][1])
            if v > 1e-3:
                print("  %s x %s  %.3f mm3" % (names[i], names[j], v))
                raise AssertionError("parts interfere: " + names[i] + " / " + names[j])
    return vol


def check_dock_and_desk(shell_m, plate_m, height, parts=(), feet=None, k=None):
    """Check seated fit, horizontal front removal, and desk use beside either half.
    Use the feet's standing plane for alignment, never lift a part just to align magnets."""
    k = K.make() if k is None else k
    dock_m = k.solid
    half = k.p(K.HALF)
    module = (shell_m + plate_m).translate((0, 0, FLOOR_Z))
    print("  in the dock: module x dock %.3f mm3, x left half %.3f, x right half %.3f; top %.2f mm over"
          " the halves' top edges" % ((module ^ dock_m).volume(), (module ^ half).volume(),
                                        (module ^ half.mirror((1, 0, 0))).volume(), height + FLOOR_Z - SPINE_TOP))
    assert all(abs((module ^ other).volume()) < 1e-3
               for other in (dock_m, half, half.mirror((1, 0, 0)))), "seated module interferes"
    mags_half = K.drawer_magnets(P)
    for (w, n), m in zip(magnets()[::2], mags_half):
        gap = (np.array(m[:2]) - w) @ n
        print("    magnet chain spans %.2f mm (dock magnet and wall between), heights %.2f / %.2f"
               % (gap, MAG_Z + FLOOR_Z, m[2]))
        assert abs(MAG_Z + FLOOR_Z - m[2]) < 1e-4, "docked magnet heights do not align"
    # on the desk: the half untented, moved along the wall's normal onto the module
    flat = K.Placement(0.0)
    mag_local = [(K.WALL_OUT, -K.D["magnets_side_y"][i], K.D["magnet_side_z"]) for i in K.DRAWER_MAGS]
    m0 = flat.points(mag_local)
    w, n = magnets()[0 if magnets()[0][0][0] < 0 else 1]
    shift = (w - np.array(m0[0][:2])) @ n
    half_desk = flat(K.HALF).translate((n[0] * shift, n[1] * shift, 0))
    body = shell_m + plate_m
    print("  on the desk with the left half: module x half %.3f mm3" % (body ^ half_desk).volume())
    for (w, n), m in zip([mm for mm in magnets() if mm[0][0] < 0], m0):
        q = np.array(m[:2]) + n * shift
        along = np.linalg.norm(q - w)
        print("    magnet: centres %.2f mm apart along the wall, heights %.2f / %.2f (module / half)"
               % (along, MAG_Z, m[2]))
        assert along < 1e-4, "standalone side magnets are not aligned"
        assert abs(MAG_Z - m[2]) < 1e-4, "standalone magnets require lifting a part"

    # The standing plane is the datum, not the printed floor: both devices stand on their feet.
    feet = bumpons() if feet is None else feet
    body += feet
    for _, part in parts:
        body += part
    assert abs(body.bounding_box()[2]) < 1e-4, "module does not stand on z = 0"
    pads_desk = flat(K.PADS).translate((n[0] * shift, n[1] * shift, 0))
    assert abs(pads_desk.bounding_box()[2]) < 1e-4, "keyboard feet do not stand on z = 0"
    for name, other in (("left", half_desk), ("right", half_desk.mirror((1, 0, 0)))):
        overlap = abs((body ^ other).volume())
        print("  standalone with %s half: %.3f mm3, both standing planes z = 0" % (name, overlap))
        assert overlap < 1e-3, "module collides with the " + name + " half"
    obstacles = dock_m + half + half.mirror((1, 0, 0))
    seated = body.translate((0, 0, FLOOR_Z))
    assert abs(seated.bounding_box()[2] - FLOOR_Z) < 1e-4
    length = OUTLINE.bounds[3] - OUTLINE.bounds[1] + 5
    worst = max(abs((seated.translate((0, -float(travel), 0)) ^ obstacles).volume())
                for travel in np.arange(0, length + 0.5, 0.5))
    print("  horizontal front removal, 0..%.1f mm: %.3f mm3 at worst; no lifting" % (length, worst))
    assert worst < 1e-3, "module cannot pull straight out through the front"
