rafaelromao/prisma/(commit log)

2026-10-22 Add the Slim Diamond: a reversible wireless Choc PCB and case
    The Diamond's layout at Choc spacing on one reversible PCB per half, with
    a XIAO nRF52840 and a 752025 battery. Keys are diodeless, one pin each;
    the 12th key uses NFC1. The case tents 6.6 degrees, the least that fits
    the battery under the inner keys, and magnets let the halves join as a
    unibody or stack back to back. Everything is generated by the scripts:
    KiCad board, JLCPCB gerbers, case STLs, renders and BOM.
    [case_left.stl, case_right.stl, slim_diamond.kicad_pcb]
2026-10-22 Shape the Slim Diamond like a diamond, joined or stacked
    Side by side, the joined halves are now a cut-diamond silhouette: the
    fewest-facet convex outline around both halves, a table at the back and
    pavilion facets down to the thumbs. The PCB follows it too. Stacked back
    to back, the case walls lean in from a floor 2 mm wider than the rim, so
    the pair reads as a cut gem from the side. Each half grows about 10%, the
    PCB still fits JLC's 100 mm tier, and the tent stays at 6.6 degrees.
    The Xiao and power switch move to the lower outer facet, with a routing
    channel around both. A spot the router can't finish falls back to the
    search's runners-up. The tent search now treats parts past the outerm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
    [case_left.stl, case_right.stl, slim_diamond.kicad_pcb]
2026-10-22 Use M3 self-tapping screws for the Slim Diamond case
    The case will be printed in Nylon, which takes a self-tapped thread well,
    so the screws move up to M3 button heads (ISO 7380) in 6 mm standoffs
    with 2.5 mm pilot holes. M3 x 6 is the longest that fits the short
    standoffs on the outer side. The screw lives in one SCREW setting in
    design.py; the hole search, the footprint and the case read it from
    there, so switching to heat-set inserts is a one-line change.
    [case_left.stl, case_right.stl, slim_diamond.kicad_pcb]
2026-10-22 Add a hand-soldering guide, and mark the Xiao holes to fill
    BUILD.md walks through one half at a time: telling the two faces apart,
    flashing the Xiao before soldering, bridging the D0-D2 jumpers, the
    castellations, the plated holes for VBAT/GND/NFC1, the power switch, the
    JST socket and the sockets, each with a multimeter check. Then testing
    with tweezers, a symptom table, the case and printing. The battery,
    magnet and assembly notes move there from BOM.md.
    Each half fills a different set of the Xiao's plated holes, and nothing
    said which. A silkscreen box now marks them on the face they're filled
    from. The routing is unchanged, and DRC is now clean: no errors and no
    warnings.
    Co-Authored-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
    [slim_diamond.kicad_pcb]
2026-10-23 Add a top plate and a solid base to the Slim Diamond
    The plate covers the whole board. It's a 1.2 mm Choc v1 plate sitting 1.0 mm over
    the PCB, with 14.0 mm cutouts (13.8 mm plus cut_tol per side). A 0.5 mm pocket in
    its underside clears the solder around the Xiao, support pillars stand on the PCB,
    and countersunk bosses take M3 x 8 flat-head screws. The screws go through the
    plate and PCB into the base, and the plate prints top face down.
    The base is now solid up to the PCB, with a pocket per part and 0.6 mm of
    clearance, so the board rests on plastic everywhere: stiffer and quieter. The
    bottom edges of the case and plate get a 45-degree chamfer for the cut-stone
    look.
    The JST socket move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
    [case_left.stl, case_right.stl, plate_left.stl, plate_right.stl, slim_diamond.kicad_pcb]
2026-10-23 Fix the Slim Diamond's USB-C, power switch and PCB fit for printing
    A review of the board and case found four things the fit check didn't
    cover:
    - USB-C: the port sat 3.6 mm behind the outer wall, in a 10 x 4.4 mm
    hole, so a cable's overmold stopped about 3 mm short of seating. The
    wall now has a recess the size of the largest Type-C overmold
    (13 x 7 mm) from the receptacle's face out.
    - The PCB's edge ran 0.86 mm past the receptacle, where a thick
    overmold reaches above the PCB's underside. The board edge is now
    notched in front of the port, and the board is rerouted (DRC clean,
    same pin map).
    - The power switch's lever reached 0.45 mm into the wall, so the PCB
    couldn't drop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
    [case_left.stl, case_right.stl, slim_diamond.kicad_pcb]
2026-10-23 Add anti-slip pads to the Slim Diamond, interleaving when stacked
    Copy the original Diamond base's pad layout (stls/v2/base_right.stl): stadium
    slots under the floor, 8.6 mm wide with two 8 x 2 mm bump-on spots 8.7 mm
    apart. The case stays one mirrored geometry; each half sticks its pad in a
    different end of every slot (the clockwise end seen from below, on both
    halves), so stacked back to back each pad drops into the other half's empty
    end and the floors and magnets still meet.
    - design.py: PAD_* constants, a slot search (pinned in PAD_SLOTS) that keeps
    every key centre deepest inside both halves' pads. Five slots per half:
    four, as on the original, leave the thumbs and pinky only 0.5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
    [case_left.stl, case_right.stl]
2026-10-23 Add a reset button to the Slim Diamond, reachable through the plate
    A 5.1 x 5.1 x 2.0 mm SMD tact switch (XKB TS-1187A-B-D-B, pads after
    KiCad's SW_SPST_TL3342) on the switch face, in the nook between the index
    column's bottom key and the thumbs, 7.65 mm from the nearest keycap. It
    reboots a closed half, and a double press enters the bootloader, which the
    Xiao's own button (facing the case floor) can't once the case is assembled.
    - Wiring: the Xiao's reset test pad (Seeed pad 17, "EN" in their symbol;
    TP2 on P0.18/RESET in their schematic) through a plated hole filled from
    the switch face, like VBAT/GND/NFC1, boxed on the silkscreen. Pads 17 and
    18 mirror onto each other, so each moun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
    [plate_left.stl, plate_right.stl, slim_diamond.kicad_pcb]
2026-10-23 Round the corners of the Slim Diamond's USB-C recess and switch slot
    The USB-C recess's section now has 1.5 mm fillets. To keep a
    square-cornered 12.35 x 6.5 mm overmold clear, it grows to 13.4 x 7.4 mm.
    The power-switch slot's floor edges get 1 mm fillets. The slot is cut as
    the inset slot grown back by a ball, so the lever's 5 mm of travel and
    the floor height stay the same.
    A full review of the board after the pads and reset button found
    nothing else to fix:
    - DRC (severity all): no violations, 0 unconnected.
    - The reset footprint matches KiCad's TL3342. RST_L and RST_R reach only
    their own half's button copy.
    - check_fit reads ALL CLEAR, and the balance margins are 2.79 mm.
    - No new t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
    [case_left.stl, case_right.stl]
2026-10-23 Add a build-log page for the Slim Diamond
    A standalone HTML page on how the board and case were generated, the
    tools, what the review caught, and the Discord post. It uses the renders
    already in the repo.
2026-10-23 Add the Slim Diamond's STLs to the stls folder and the readme
    case.py now also writes the case and plate STLs for both halves to
    stls/slim_diamond, so the copies stay in step with each regeneration.
2026-10-23 Put six magnets in each Slim Diamond seam wall instead of two
    Two 5x2 magnets per inner wall might not hold the unibody firmly. The
    seam now takes as many as fit, spread evenly at least 8.5 mm apart (3.3 mm
    of plastic between them), wherever the battery and its socket leave the
    wall clear: one at y 5, and five from y 25.5 to 61.5. Each one clears
    every pocket with 0.5 mm to spare (check_fit ALL CLEAR). BOM: 12 (+4).
    [case_left.stl, case_right.stl]
2026-10-23 Use 8x3 magnets throughout the Slim Diamond, as many and as spread as fit
    One magnet part everywhere, the strongest join that fits:
    - Seam: six 8x3 per inner wall, in one row at 6.3 mm, spread evenly
    over the whole wall (y 10.1 to 64.2). Of the common sizes, that pulls
    hardest: about 12 kg, against ~3.6 kg for six 5x2, 11.6 kg for four
    10x3, or 4.8 kg for eight 5x2. No size fits a second row under the
    PCB.
    - Floor: four 8x3 per half (were 6x2), as far apart as the floor's
    depth allows: the closest two are 44.3 mm apart.
    magnets.py finds both sets by measuring the solid base (slices
    parallel to the floor and to the seam face), with 0.5 mm of plastic
    round every pocket. design.py pi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
    [case_left.stl, case_right.stl]
2026-10-23 Present the Slim Diamond on its page as it is, without its history
    The review section described past problems and their fixes. It now
    describes what the checks cover in the current design. The page also
    links the repo's main branch.
2026-10-23 Show more renders on the Slim Diamond page
    The bare board's two faces, both halves' Xiao close-ups, the tent from
    the front, the switch side, the placement plot, the plate from above,
    and both halves joined from above and stacked.
2026-10-23 Add a Super52840 version of the Slim Diamond board
    The NologoTech Super52840 (also sold as "MINI NRF52840", "NRF52840
    RE:1.4") has the XIAO nRF52840's 14 edge pins on the same nRF52840 pins,
    but different pads underneath. Measured from photos against the 2.54 mm
    pin pitch, its RST, GND and SWD pads land within 0.1 mm of the XIAO's:
    - B+ and B- sit where the XIAO has GND and VBAT, swapped.
    - P0.09 is in a row of nine GPIO pads, 1.3 mm from the XIAO's NFC1.
    - Its four USB-C legs come through its board.
    footprints.py now generates the module footprint from per-module data
    (MODULES), and build_pcb/route/fab take MODULE=super52840, building in
    pcb_super52840/ and fab/slim_diamond_super52840_jlcp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
    [slim_diamond.kicad_pcb]
2026-10-23 Show both boards, the BOM and the build guide on the Slim Diamond page
    The page compares the XIAO and Super52840 boards, with both boards'
    close-ups. page.py fills its BOM and build-guide sections from BOM.md and
    BUILD.md. The build guide now names both modules and their silkscreens.
2026-10-23 Make one Slim Diamond board for both the XIAO and the Super52840
    The two boards become one. The modules differ only under the battery,
    the 12th key and the USB-C legs; their edge pins, reset pad and firmware
    are the same.
    - Battery: one small fill hole per pad spot (BATM, nearer the middle;
    BATU, nearer the USB end), inside both modules' pads and 0.25 mm clear
    of the Super52840's GPIO row under the other half's module. The pads
    are swapped between the modules, so a selector on the switch face picks
    which hole is +: two rows of solder jumpers, labelled by what they do,
    +MID (the XIAO) and +USB (the Super52840). It sits inside the module
    outline, clear of both modules' pads and th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
    [slim_diamond.kicad_pcb]
2026-10-23 Correct the Super52840 leg clearance and P0.09 hole from a second photo
    A photo beside a ruler, measured against the 2.54 mm pin pitch like the
    first, agrees on the battery pads (within 0.1 mm) but places the USB-C leg
    slots at y -4.76 and -8.94. The first estimate, -4.0 and -8.8, was read
    by eye and had the inner pair 0.8 mm off. Detected the same way in both
    photos, the slots measure about 0.7 x 2.0 mm, so the clearance holes are
    now 1.2 x 2.6 mm on them. The GPIO row sits at x 5.06 or 5.3 depending
    on the photo, so the P0.09 hole moves to 5.2, inside the pad either way.
    The larger holes left 4 connections unrouted at 0.15 mm clearance;
    0.14 (JLCPCB's minimum is 0.127) routes completely,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
    [slim_diamond.kicad_pcb]
2026-10-23 Note that the XIAO nRF52840 is flat underneath
    Checked on a real one: its USB-C has no legs through its board, so it
    lies flat over the Super52840's leg clearance holes.
    [footprints.py]
2026-10-23 Allow for the Super52840's off-centre USB-C
    More photos of the Super52840, one straight top-down with a ruler
    (21.75 px/mm, matching the pin pitch), show its USB-C 0.3 to 0.6 mm off
    centre, towards the D0..D6 pins. The leg slots in the earlier photos are
    off centre the same way. The halves are mirrored, so the offset flips
    between them, and everything around the port now allows for it either way:
    - Leg clearance holes are 1.6 mm wide (were 1.2), covering the legs at x
    -4.65 and +4.05 in both halves.
    - The notch in the PCB edge is 14.2 mm (was 13.0), and the case's recess
    14.6 mm (was 13.4).
    - check_fit plugs in a full-size cable centred and 0.6 mm off either
    way: all 0 mm3.
    A third re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
    [case_left.stl, case_right.stl, slim_diamond.kicad_pcb]
2026-10-26 Enlarge the battery and P0.09 fill holes as far as the pads allow
    The holes fed with solder to reach the module's battery pads and the
    Super52840's P0.09 pad were 0.5 mm. Solder might not flow through them.
    - Battery (BATM, BATU): 0.6 mm drill, 0.88 mm ring (0.14 annular;
    JLCPCB's minimum is 0.13). 0.7 left too thin a ring. The drill stays
    inside both modules' pads, and the mirror copy stays 0.17 mm clear of
    the Super52840's GPIO row under the other half's module, at the
    photos' nearest reading.
    - P0.09 at the Super52840's pad: 0.6 mm drill, 1.0 mm ring, inside
    the pad at all three readings of its position.
    A taller oval ring closed the one track channel to L1/L13 past the
    USB-C l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
    [slim_diamond.kicad_pcb]
2026-10-26 Hold the Slim Diamond board to JLCPCB's limits, and add pre-order checks
    The board is made in a single batch, so every check that can run before
    ordering now does.
    JLCPCB's 2-layer limits, encoded in pcb/slim_diamond.kicad_dru so the
    DRC enforces them, found two things:
    - The battery fill holes' ring was 0.14 mm; JLCPCB needs 0.18. They
    are now 0.6 mm drills in 0.96 mm rings, 0.02 mm further in. The mirror
    copy still clears the Super52840's GPIO row (0.15 mm at the nearest
    photo reading, 0.29 at the middle one), and the drill stays inside both
    modules' pads.
    - Silkscreen: text is now 1.0 mm high with 0.15 strokes, and lines are
    0.15 (they were 0.8 and 0.12).
    Tracks and vias are k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
    [slim_diamond.kicad_pcb]
2026-11-02 Add a cyberdeck dock for the Slim Diamond
    A phone on a Ugreen folding stand (base 85 x 105 x 4 mm) is the
    computer and the screen. dock.py makes one printed part that holds both
    halves around it. Without the stand it is a tented, splayed unibody.
    - Over the stand's base, in a pocket in its underside: the base keeps
    its own feet on the desk and carries the phone. Its back strip with
    the hinge is left bare, 0.5 mm off the halves and the dock, as far
    forward as they allow. Five magnets in the pocket's roof snap onto
    five glued on top of the base.
    - The halves on wings the shape of their floors, inner side up, outer
    pad on the desk, splayed 12 degrees. The extra tent is the least that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
    [dock.stl]
2026-11-05 Finish Slim Diamond drawer modules and audited case redesign
    Add shared MX/Choc trackball PCB, trackpad module, full-depth USB dock passage, 500 mAh half cases and independent stand contacts. Fix screw seats, lever access, foot roofs, floor servicing and binary STL topology from the blind artifact audit.
    Regenerate STLs, routed PCB/fab outputs and renders; retain rigid-board wiring with cited JLCPCB flex feasibility research. Verify 21 geometry/export tests and zero DRC errors/unconnected items on both boards. Record required hood supports, physical-validation limits and the incomplete independent follow-up.
    [bottom_plate.stl, case_left.stl, case_right.stl, dock.stl, insert.stl, plate_left.stl, plate_right.stl, shell.stl]
2026-11-05 Rebuild the pointing modules as a shared tray and lid
    Close them from the top with the halves' M3 x 8 screws, share the main
    board, sensor board and tray between trackball and trackpad, centre the
    drawer magnet, and space the boards apart on the panel.
    [bottom_plate.stl, dock.stl, insert.stl, lid.stl, lid_choc.stl, module_tray.stl, shell.stl, shell_choc.stl]
2026-11-05 Refine shared pointing modules and build guides
    [case_left.stl, case_right.stl, dock.stl, insert.stl, lid.stl, lid_choc.stl, module_tray.stl, trackball.kicad_pcb]
2026-11-05 Add wired XIAO pointing controller option
    [trackball_xiao.kicad_pcb]
2026-11-06 One shared wired-controller PCB, I2C trackpad breakout, front facets, dock magnet web
    - One carrier PCB serves nice!nano v2 or plain XIAO nRF52840 by wires; XIAO placement outline on the silkscreen, Seeed STEP-derived reference for the rear USB datum, controller pin maps and firmware shields checked against PCB nets
    - Trackpad keeps the supplied I2C breakout and FFC plus a separate DR wire (provisional clearance envelope, no holder); I2C firmware for both MCUs
    - Upper facet on the module fronts as well as the sides
    - Dock: three underside stand pairs, 1 mm web to the drawer-floor magnet at +/-0.2 mm
    - Rear lid screws moved back for a 2.5 mm web to the pad seat; trackpad takes the sensor shim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
    [dock.stl, lid.stl, lid_choc.stl, module_tray.stl, trackball.kicad_pcb, trackball_xiao.kicad_pcb]
2026-11-06 Wiring diagrams for both controllers; clearer XIAO position box on the carrier silkscreen
    [trackball.kicad_pcb]
2026-11-06 Move carrier wire pads beside the XIAO's pins; one pin per pad on both modules
    - Pads sit level with a face-down XIAO's pins; silkscreen table gives each pad's pin on both controllers
    - Same controller wiring for trackball and trackpad; firmware pins updated for all four shields
    - XIAO reference turned over, not mirrored; true-position wiring diagrams for both controllers
    - Controller supports 1 mm lower for wires on the XIAO's back pads, with a second pair under its middle
    - Tape retention specified; review wording and diagram fixes
    [module_tray.stl, trackball.kicad_pcb]
2026-11-07 Put the controller on its own board, joined to the main board by stacking pins
    - A third board on the same panel: the controller stands on a 2.54 mm header in true 15.24 mm columns
    - Eight 15 mm stacking pins join it to the main board; the main board is no longer removable
    - One 3V solder jumper selects XIAO or nice!nano; battery and reset are the only controller wires
    - Printed seats and stops replace the piers; signal pins moved on all four shields
    - Solid copper joins each wire pad to its stacking pin; ground pour clearance is now really 0.25 mm
    - Stray single-layer vias pruned; pipeline diagrams, build guide, BOM and renders updated
    [module_tray.stl, trackball.kicad_pcb]
2026-11-07 Bring the page's hand-written text in line with the controller board
2026-11-07 Show and check how the controller board's stacking pins meet the main board
    - check_controller_pcb.py undoes the panel's quarter turn and asserts all eight stacking pairs coincide
    - Measured plan and section diagram, and assembled, lifted and top 3D renders of the two-board stack
    - A test fails if the routed boards' stacking holes ever drift apart; page and guide show the renders
    [render_manifest.py, scene.py, test_xiao_option.py]
2026-11-07 Add nice!nano versions of the two-board stack renders
2026-11-08 Draw the wires into the two-board stack renders
    - Each main-board wire pad gets its wire, coloured by signal: sensor or trackpad wires run forward over
    the controller, battery and reset come up from the controller
    - Low views from the front corner for both controllers, with a colour key on the page and in the guide
    [render_manifest.py, scene.py]
2026-11-08 Divide the build page into tabs
    - Seven tabs: overview, the halves, how it is made, the dock, pointing modules, parts, build guide
    - Each tab has its own #fragment; links into a tab open it; arrow keys, Home and End move between tabs
    - Without JavaScript the page stays one long scroll; print shows every section
    - The build guide gets a sticky, grouped contents list, generated by page.py from its headings
    - Two lists in BUILD.md that rendered as run-on paragraphs now render as lists
2026-11-08 Tie the stacking-hole check to the board it measured, not to file times
    A checkout can leave the alignment data a millisecond older than the board; record the board's hash instead
2026-11-08 Bring the published STL set alongside the sources
    [case_left.stl, case_right.stl, dock.stl, insert.stl, module_tray.stl, plate_left.stl, plate_right.stl, trackball_lid.stl]
2026-11-08 Rebrand Slim Diamond as Prisma
    [case_left.stl, case_right.stl, dock.stl, insert.stl, lid.stl, lid_choc.stl, module_tray.stl, plate_left.stl]
2026-11-08 Put PRISMA in low relief on the placeholder's top
    The drawer placeholder gets the word PRISMA raised 0.5 mm behind the
    diamond, in DejaVu Sans Bold condensed to 34 x 7.2 mm. The render, BOM,
    README and page are regenerated to match.
    [insert.stl]
2026-11-08 Leave the screws out of the closed module renders
    The built trackball and trackpad renders showed their lid and sensor-board
    screws while the halves show none. The screws are now left out of every
    module scene that shows the module as built (closed, cut open, docked,
    with a half, USB views, the cyberdeck), so the module matches the halves.
    The exploded views keep the screws, because the build guide shows them
    going in. The closed seam view loses its screws and its caption says so.
2026-11-08 Tighten the landing page: trim prose, merge repeated facts, shorten captions
2026-11-08 Independent tenting: assume a steel stand, no glued discs
2026-11-08 Address pre-print and blind-review findings
    [case_left.stl, case_right.stl, lid.stl, lid_choc.stl, module_tray.stl, trackball_lid.stl, trackball_lid_choc.stl, trackpad_lid.stl]
2026-11-09 Correct Choc switch mounts and document manufacturer dimensions
    [lid.stl, lid_choc.stl, trackball_lid_choc.stl, trackpad_lid.stl]
