rafaelromao/prisma/(notices)

Notices in the files:
parts and their libraries:
PixArt PMW3610DM-SUDU on the back face, LM18-LSI lens on the front; after siderakb/pmw3610-pcb (CERN-OHL-P-2.0)
